DynoScan3D/DynoScan3D/Arduino Script/README.md

# Arduino-Controls

Arduino controls for turntable. Requires python script for serial communication.

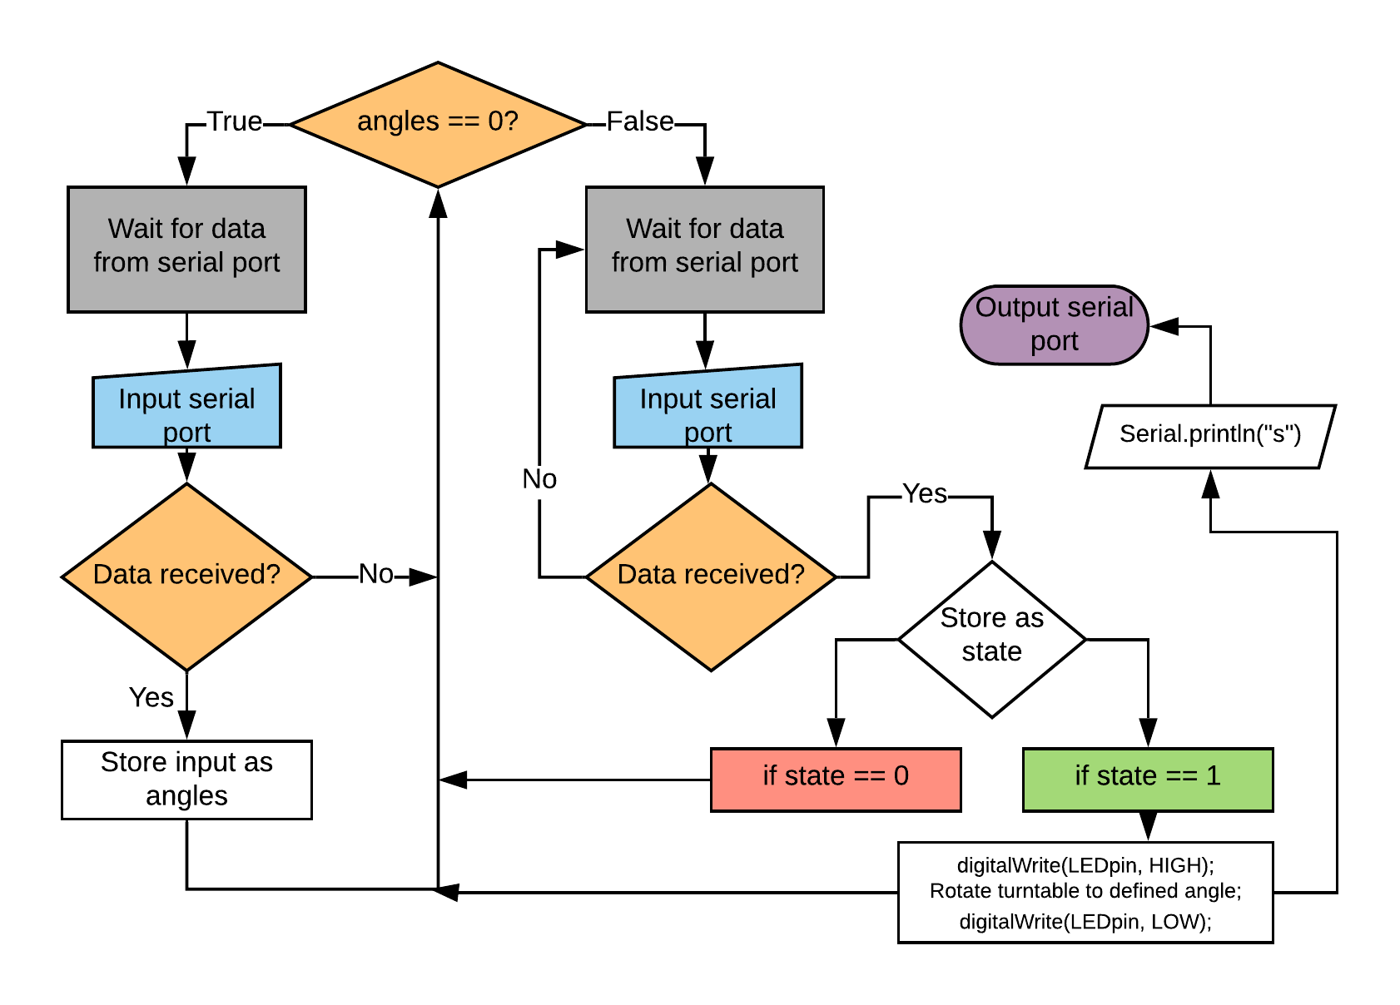
[picture p1: Arduino Script/ArduinoControlsChart.png]
ArduinoControlsChart
