DynoScan3D/DynoScan3D/AndroidImageCapture/ProjectAndCapturewithArduinoChart.png

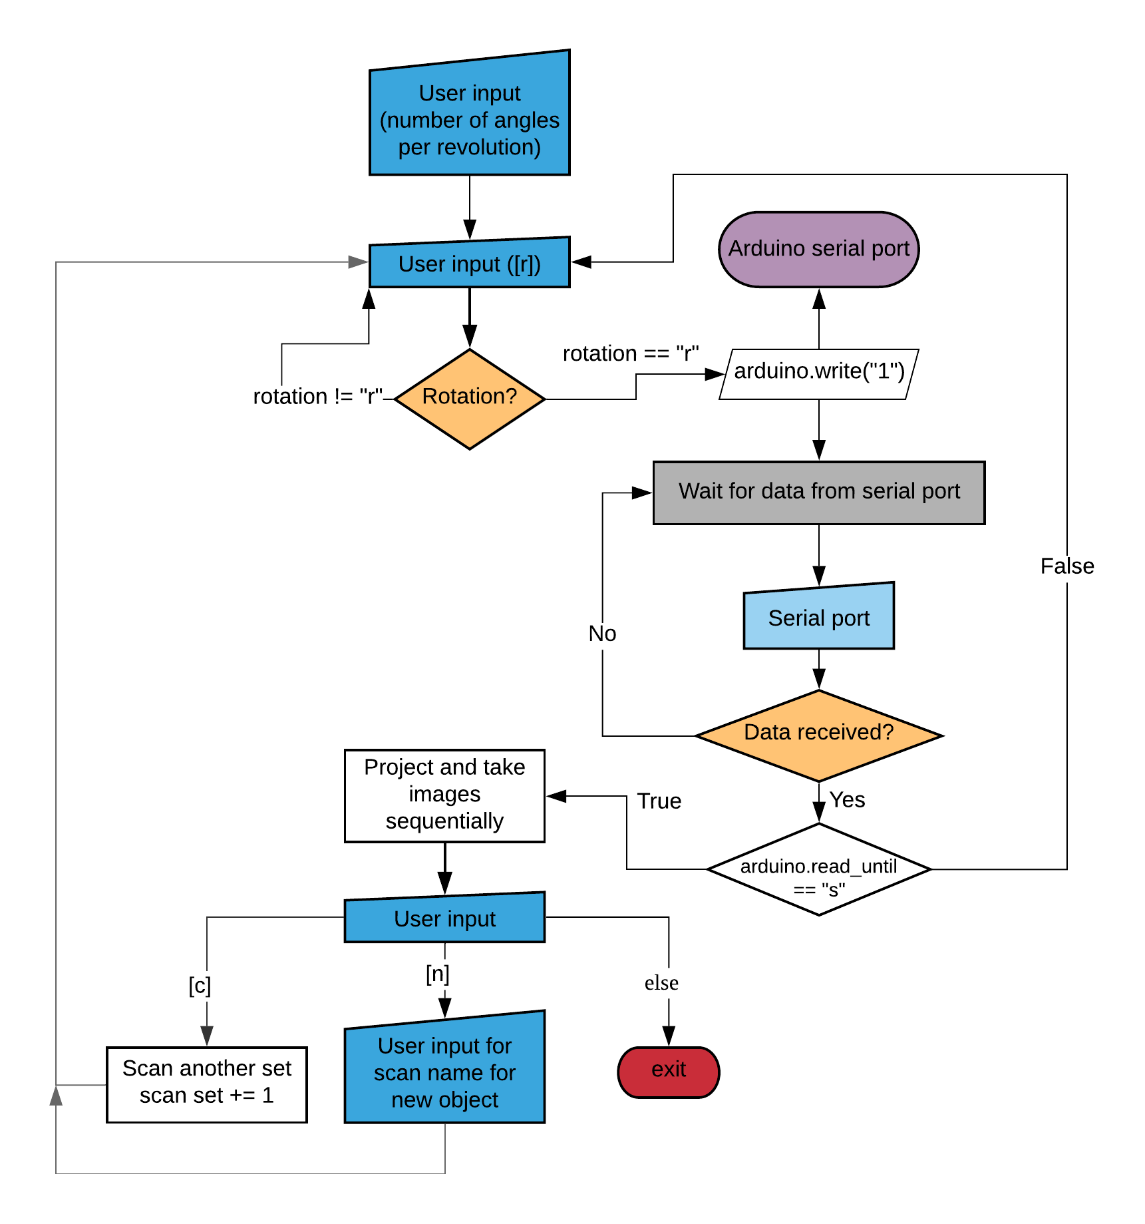
AndroidImageCapture/ProjectAndCapturewithArduinoChart.png
