DynoScan3D/DynoScan3D/DSLRImageCapture/GrayCodeImages/GrayCode3.jpg

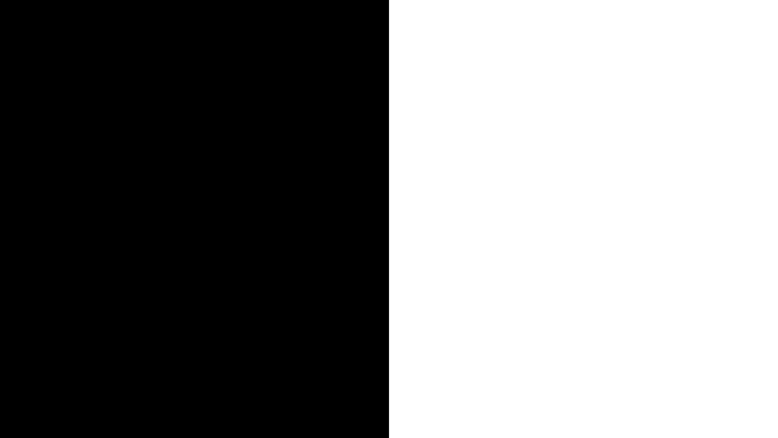
DSLRImageCapture/GrayCodeImages/GrayCode3.jpg
