DynoScan3D/DynoScan3D/DSLRImageCapture/GrayCodeImages/GrayCode4.jpg

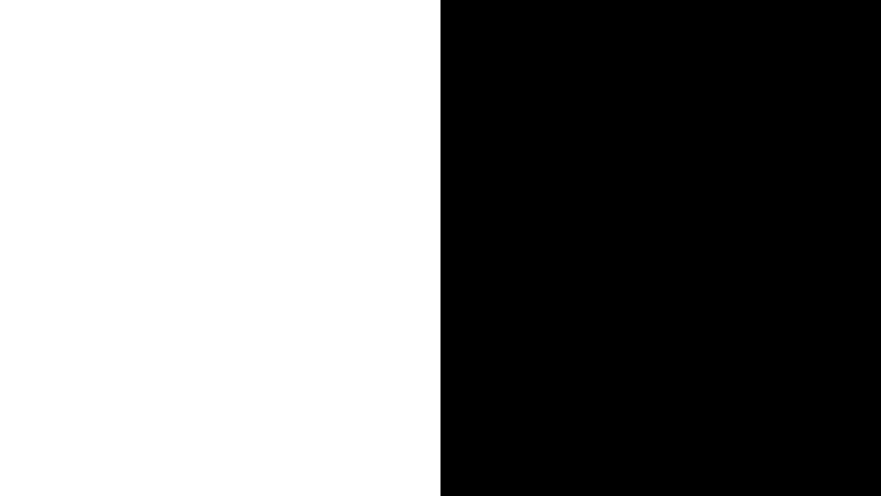
DSLRImageCapture/GrayCodeImages/GrayCode4.jpg
