DynoScan3D/DynoScan3D/DSLRImageCapture/GrayCodeImages/GrayCode5.jpg

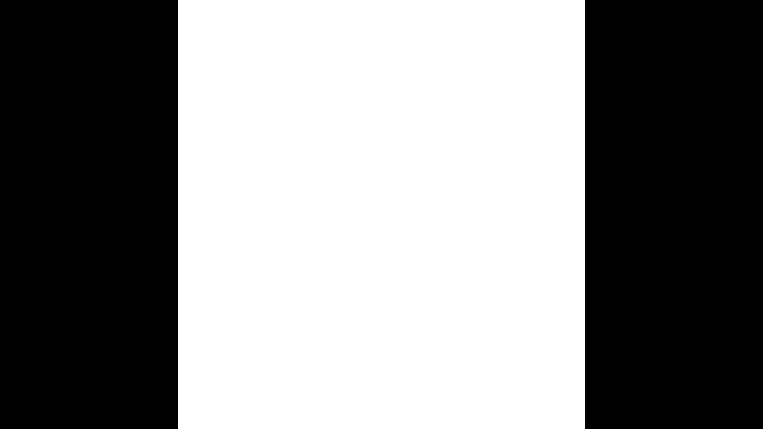
DSLRImageCapture/GrayCodeImages/GrayCode5.jpg
