DynoScan3D/DynoScan3D/DSLRImageCapture/GrayCodeImages/GrayCode6.jpg

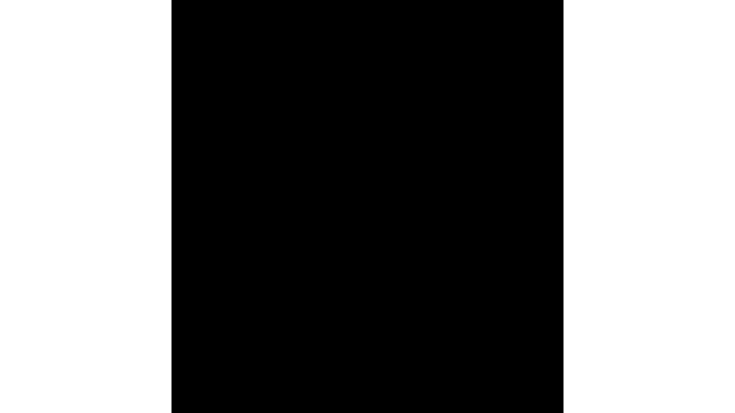
DSLRImageCapture/GrayCodeImages/GrayCode6.jpg
