DynoScan3D/DynoScan3D/DSLRImageCapture/GrayCodeImages/GrayCode7.jpg

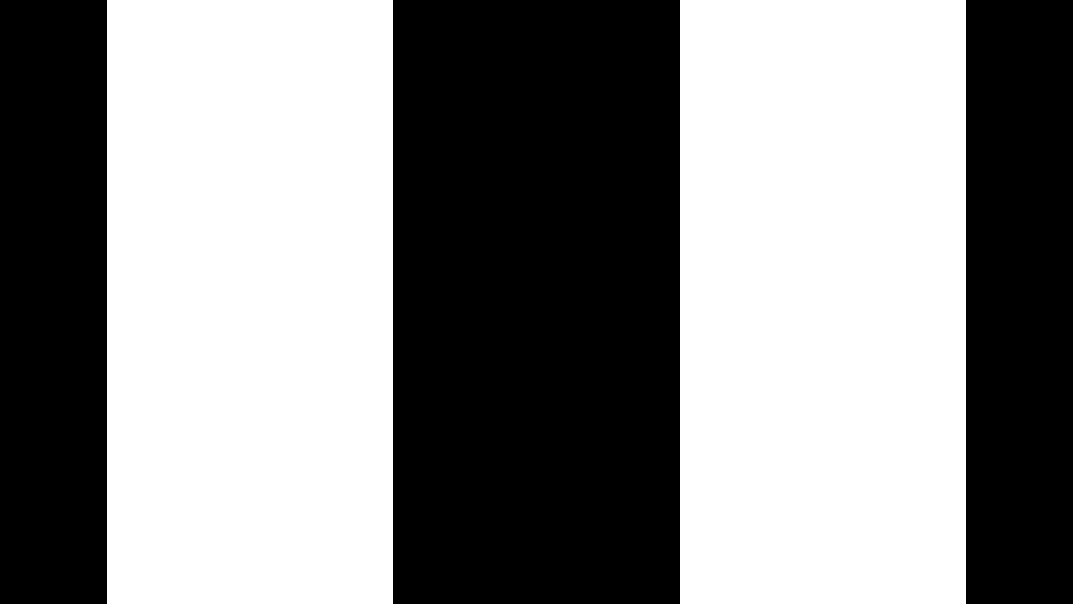
DSLRImageCapture/GrayCodeImages/GrayCode7.jpg
