DynoScan3D/DynoScan3D/DSLRImageCapture/GrayCodeImages/GrayCode8.jpg

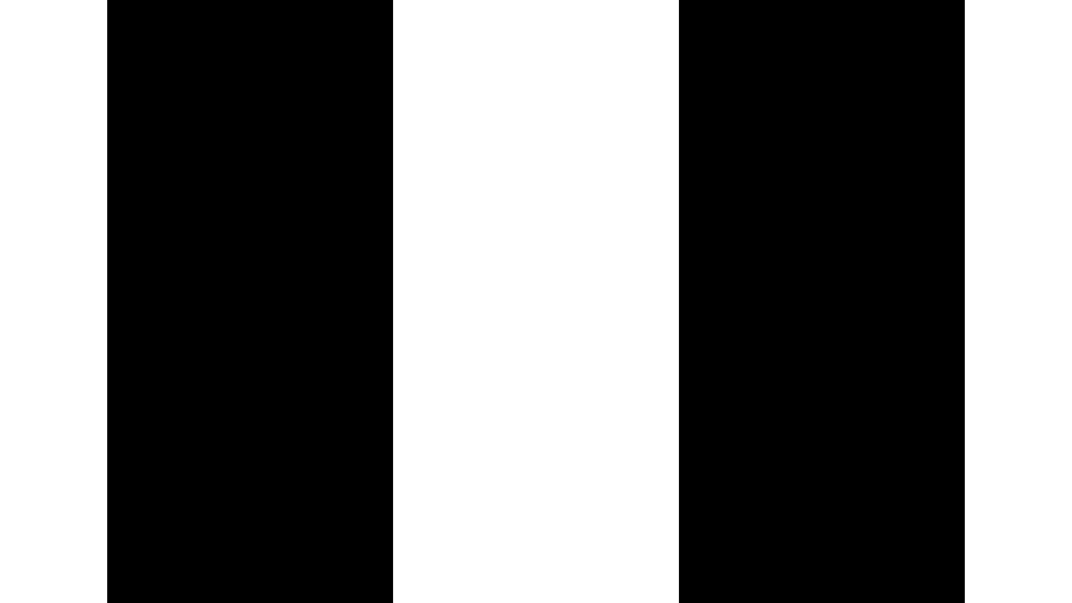
DSLRImageCapture/GrayCodeImages/GrayCode8.jpg
