DynoScan3D/DynoScan3D/DSLRImageCapture/GrayCodeImages/GrayCode9.jpg

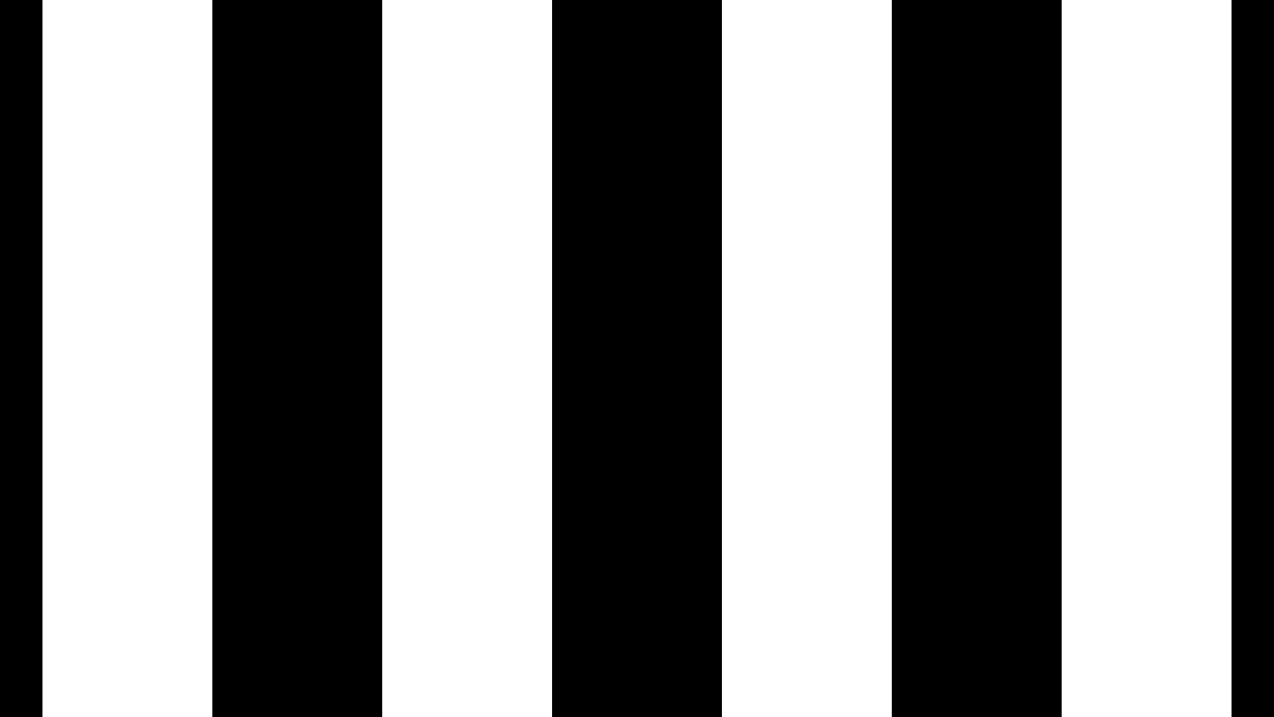
DSLRImageCapture/GrayCodeImages/GrayCode9.jpg
