DynoScan3D/DynoScan3D/DSLRImageCapture/GrayCodeImages/GrayCode10.jpg

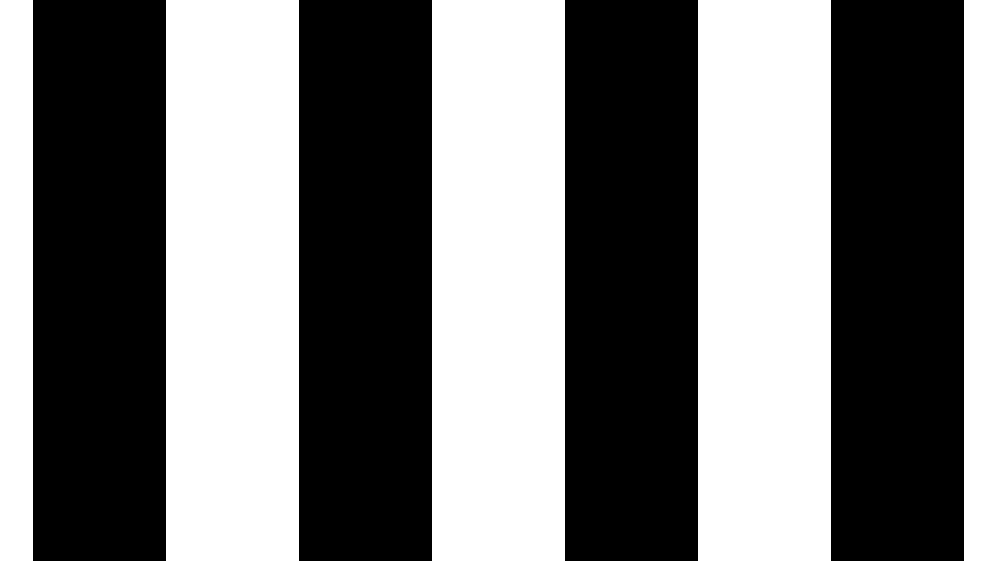
DSLRImageCapture/GrayCodeImages/GrayCode10.jpg
