DynoScan3D/DynoScan3D/DSLRImageCapture/GrayCodeImages/GrayCode13.jpg

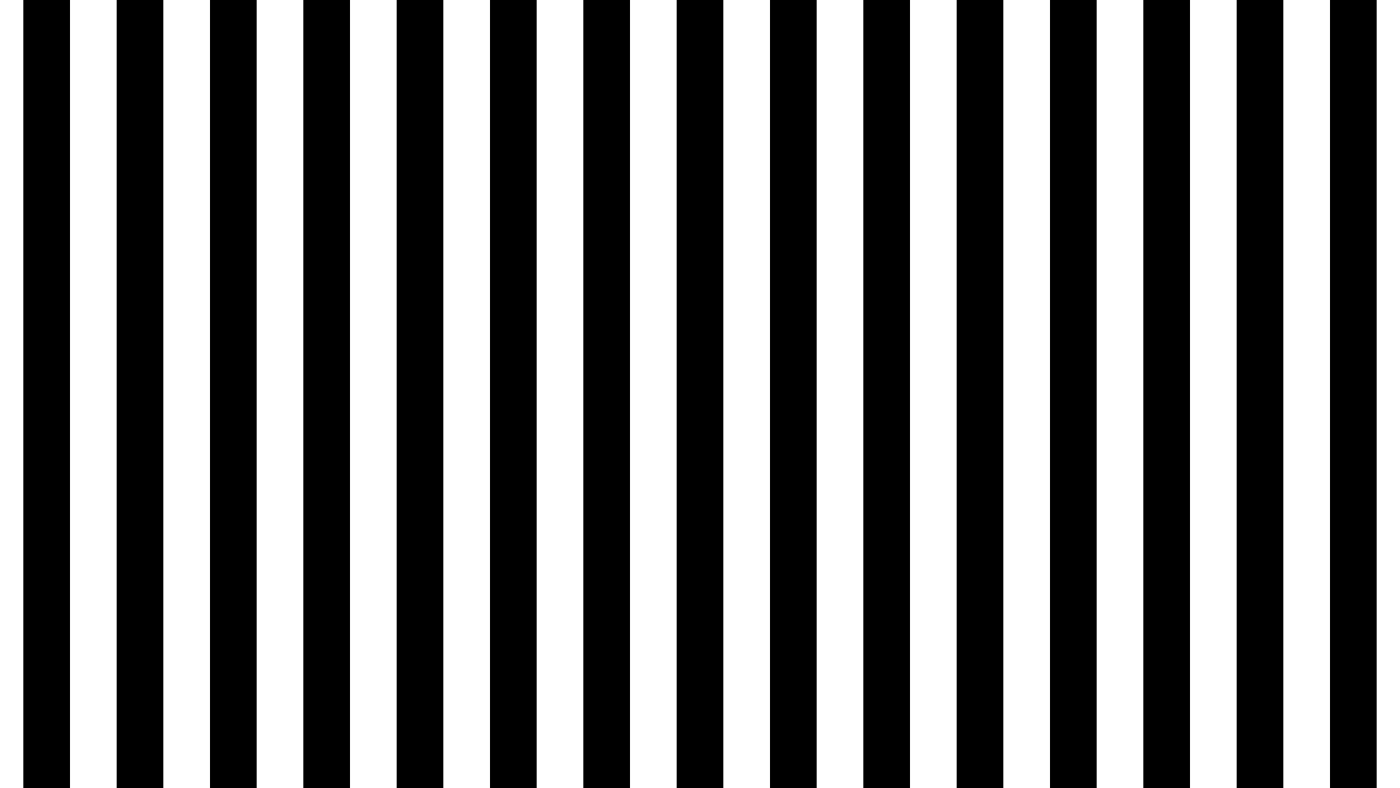
DSLRImageCapture/GrayCodeImages/GrayCode13.jpg
