DynoScan3D/DynoScan3D/DSLRImageCapture/GrayCodeImages/GrayCode14.jpg

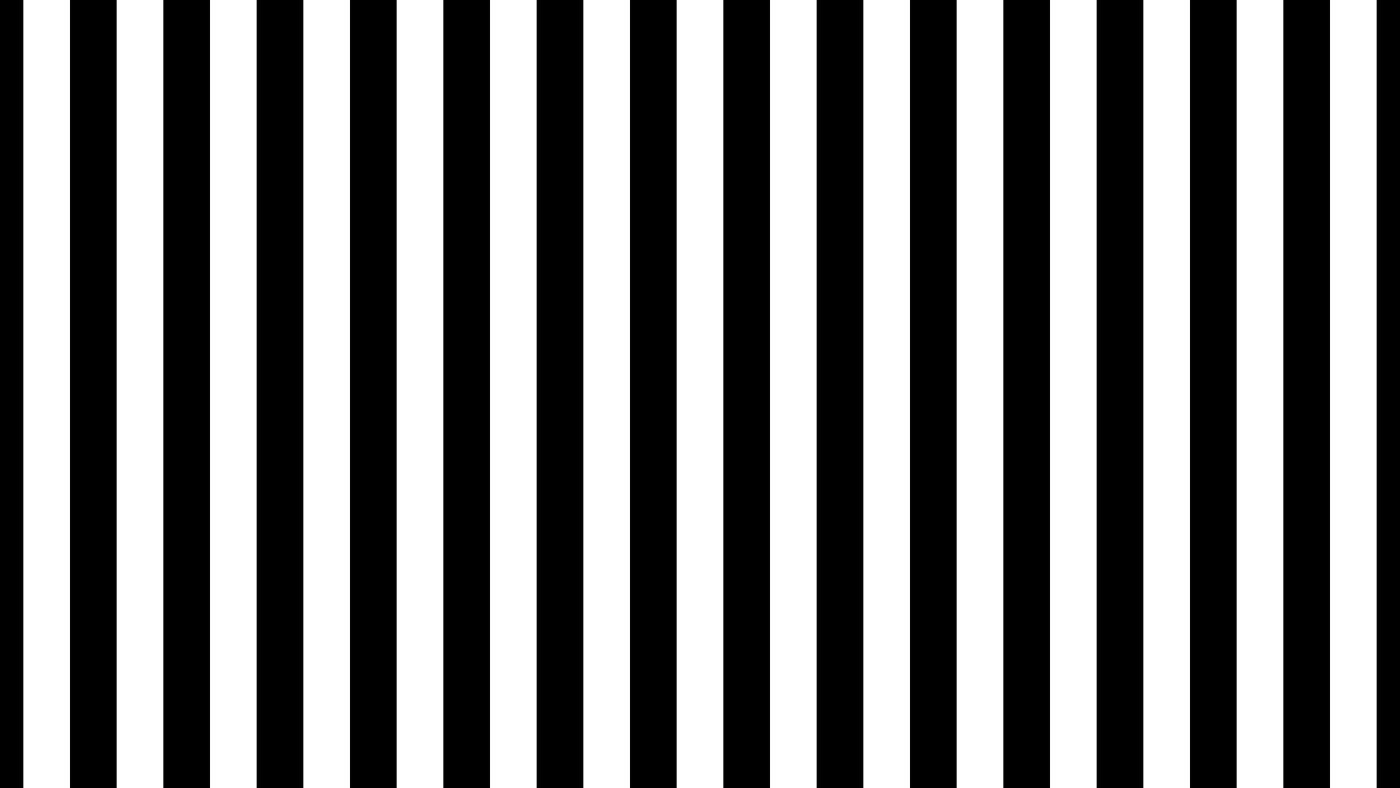
DSLRImageCapture/GrayCodeImages/GrayCode14.jpg
