DynoScan3D/DynoScan3D/DSLRImageCapture/GrayCodeImages/GrayCode18.jpg

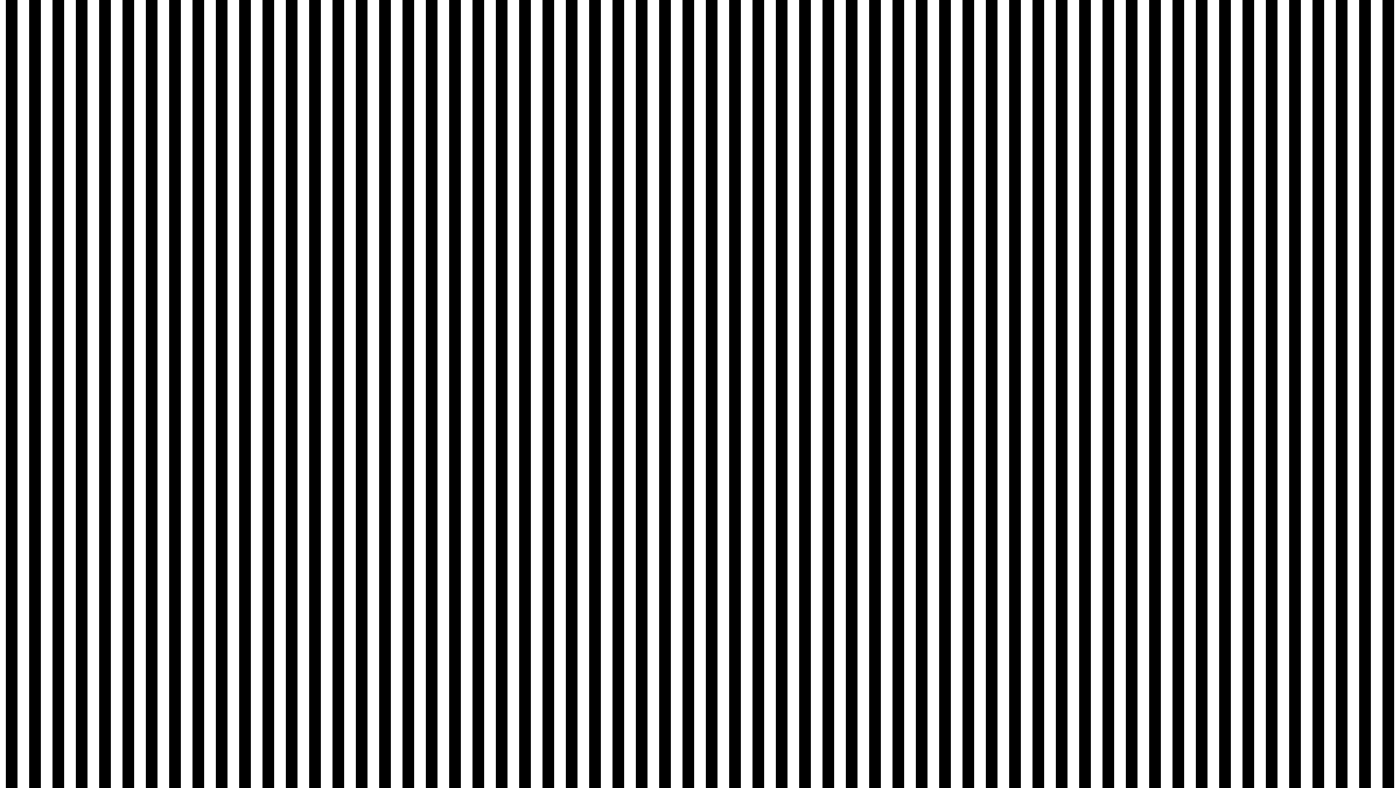
DSLRImageCapture/GrayCodeImages/GrayCode18.jpg
