DynoScan3D/DynoScan3D/DSLRImageCapture/GrayCodeImages/GrayCode20.jpg

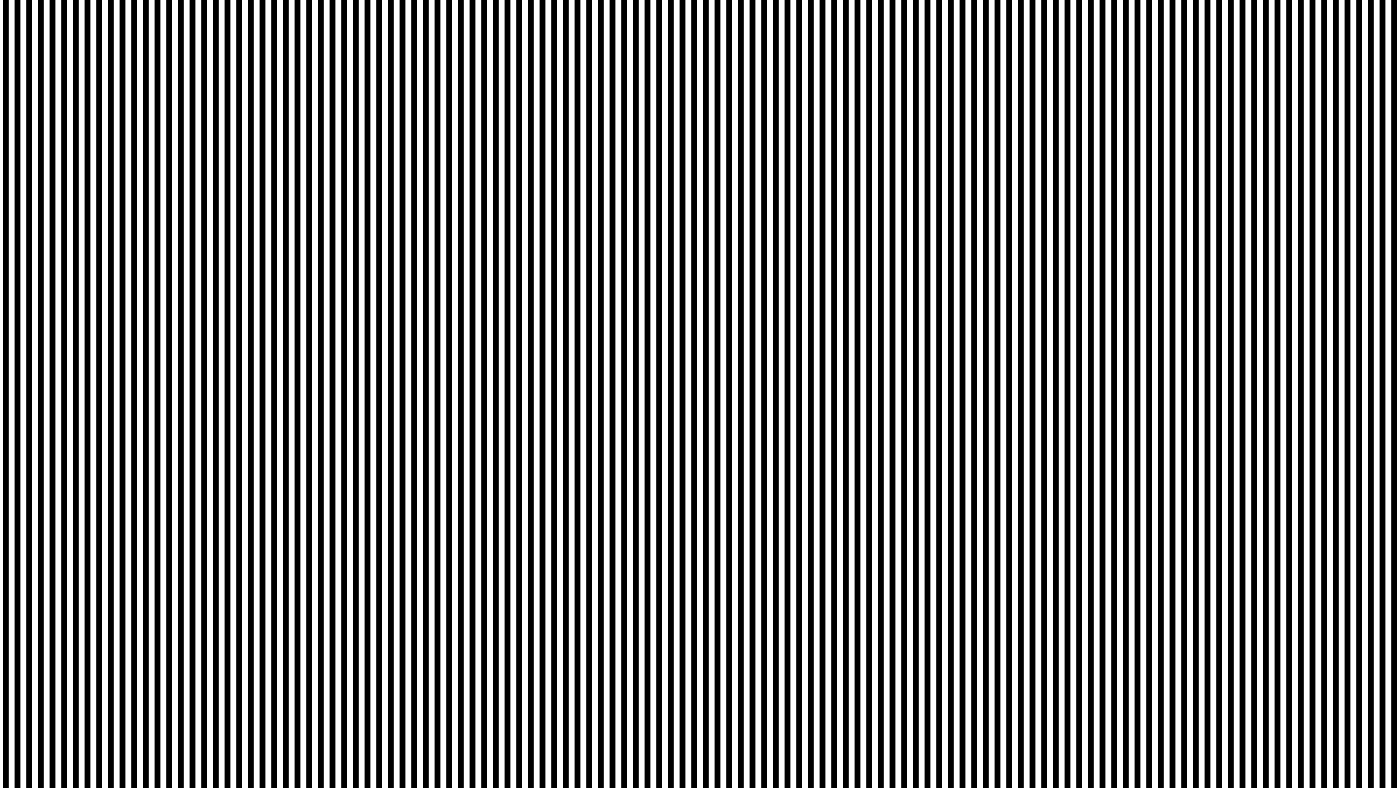
DSLRImageCapture/GrayCodeImages/GrayCode20.jpg
