DynoScan3D/DynoScan3D/GrayCode/Image/GrayCode023.jpg

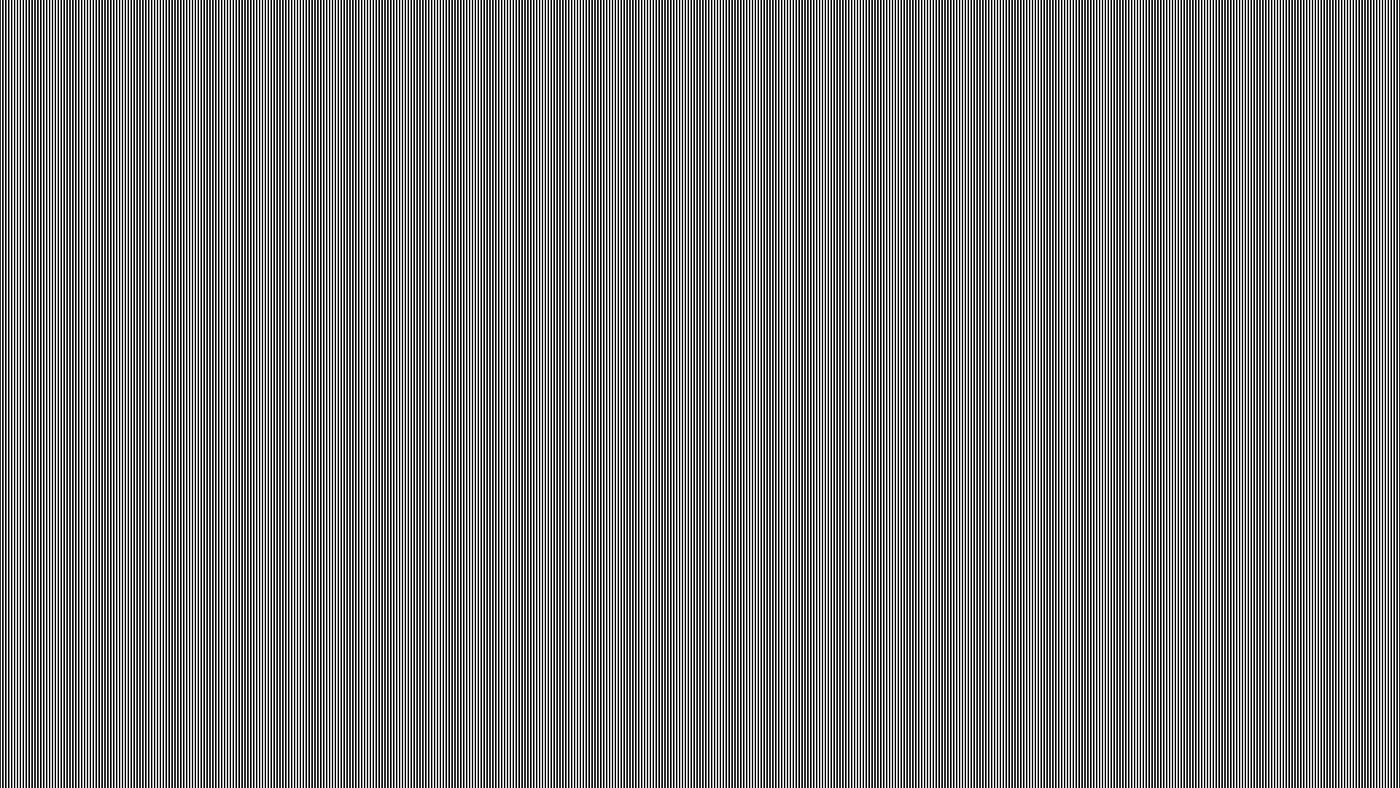
GrayCode/Image/GrayCode023.jpg
