DynoScan3D/DynoScan3D/PointCloudDistances/PhoneCar.png

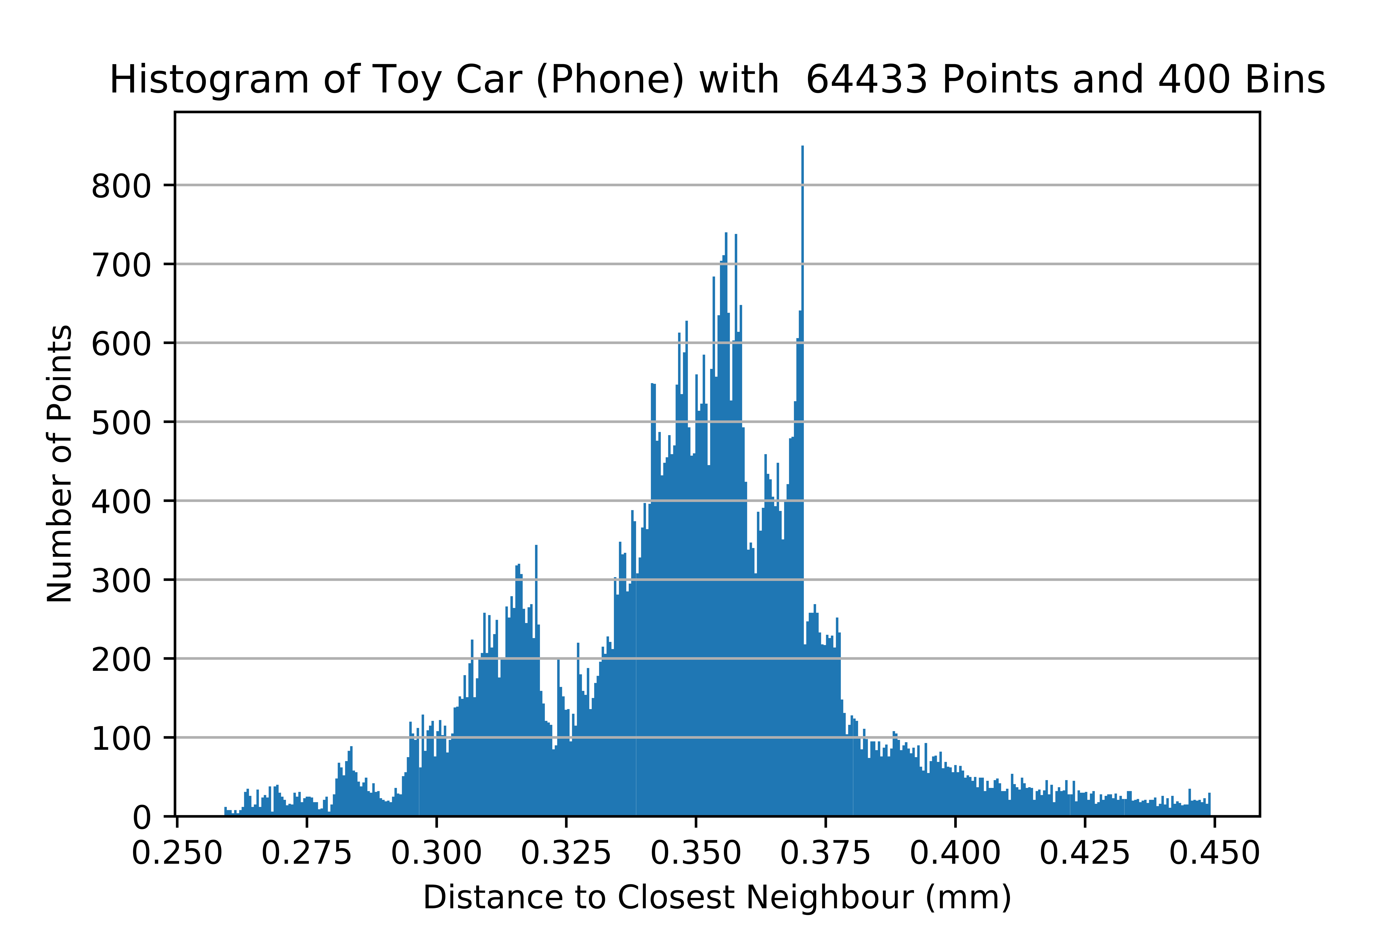
PointCloudDistances/PhoneCar.png
