DynoScan3D/DynoScan3D/PointCloudDistances/ShinyBlade5.png

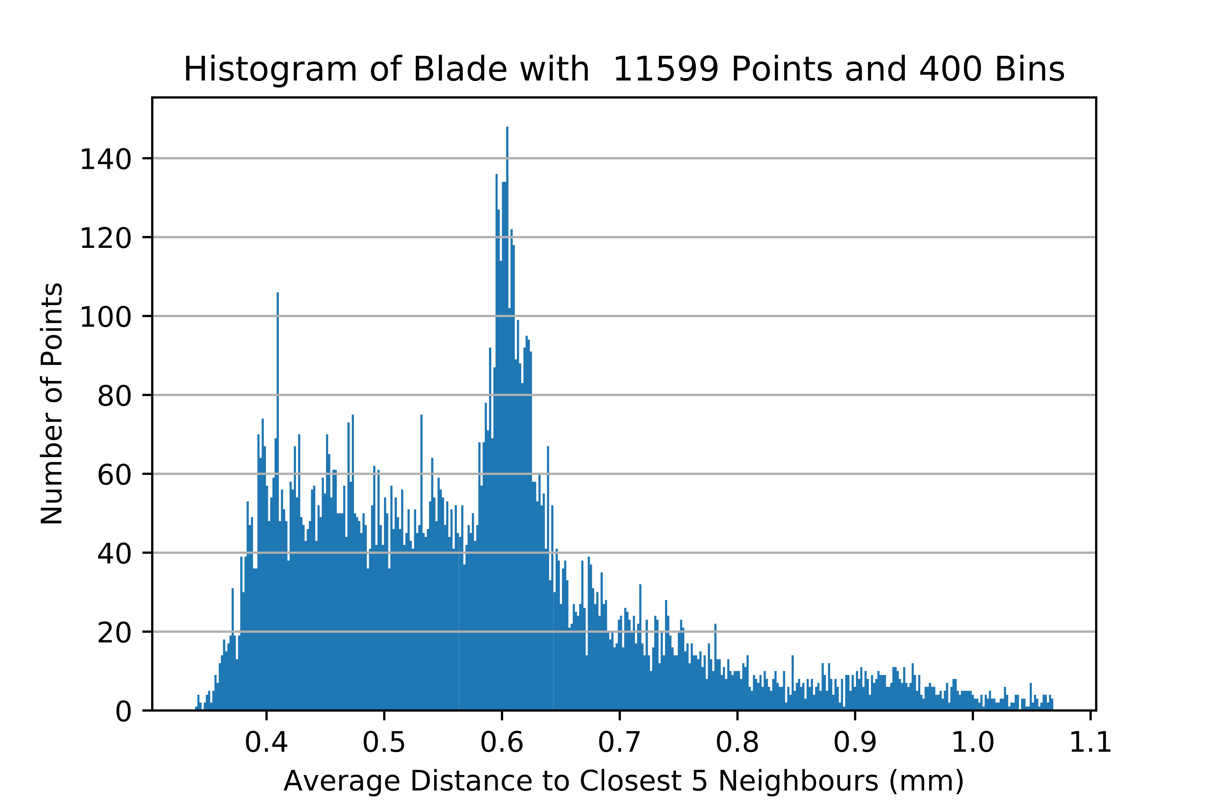
PointCloudDistances/ShinyBlade5.png
