DynoScan3D/DynoScan3D/PointCloudDistances/ShinyBlade.png

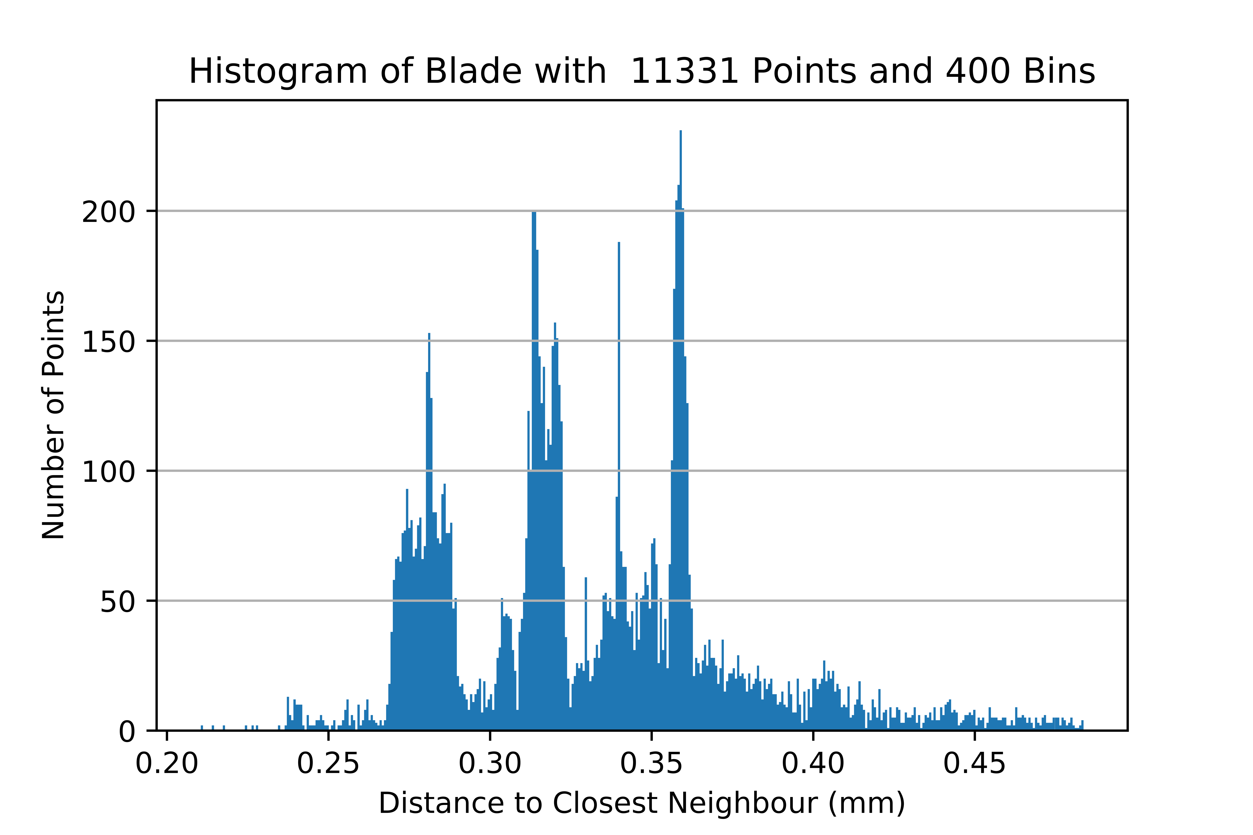
PointCloudDistances/ShinyBlade.png
