DynoScan3D/DynoScan3D/PointCloudDistances/SprayedBlade5.png

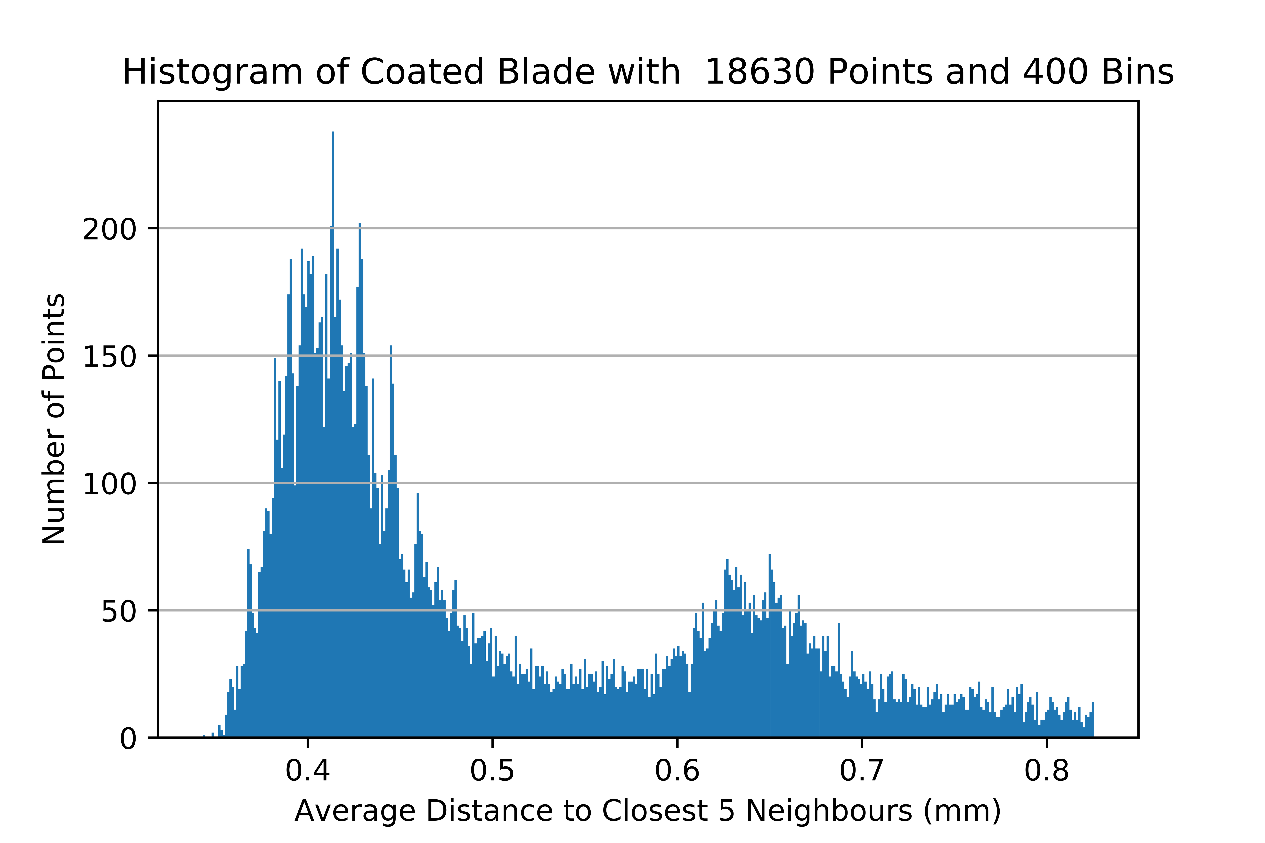
PointCloudDistances/SprayedBlade5.png
