DynoScan3D/DynoScan3D/PointCloudDistances/SprayedBlade.png

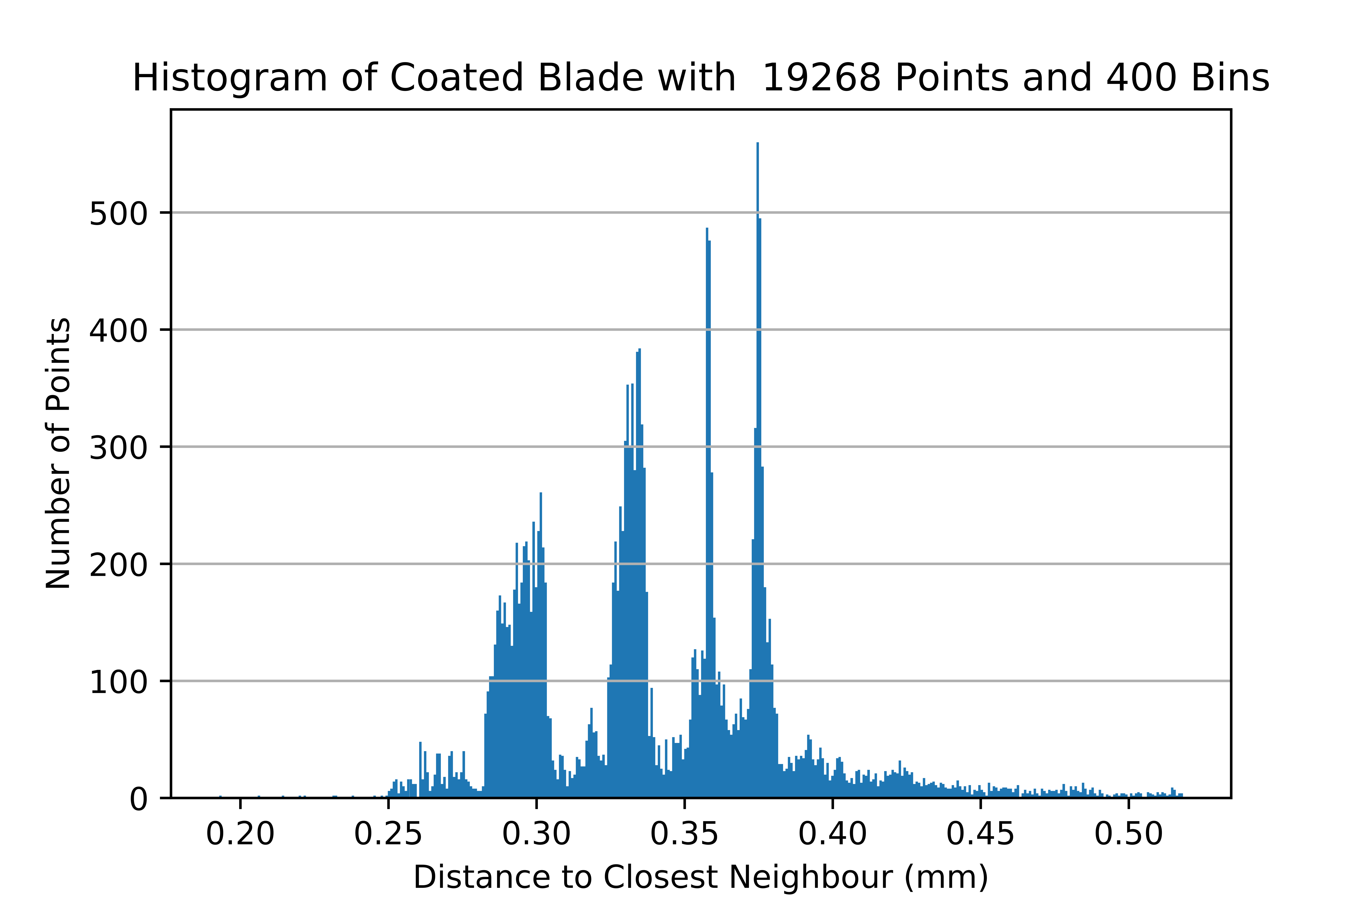
PointCloudDistances/SprayedBlade.png
