DynoScan3D/DynoScan3D/PointCloudDistances/WebcamCar.png

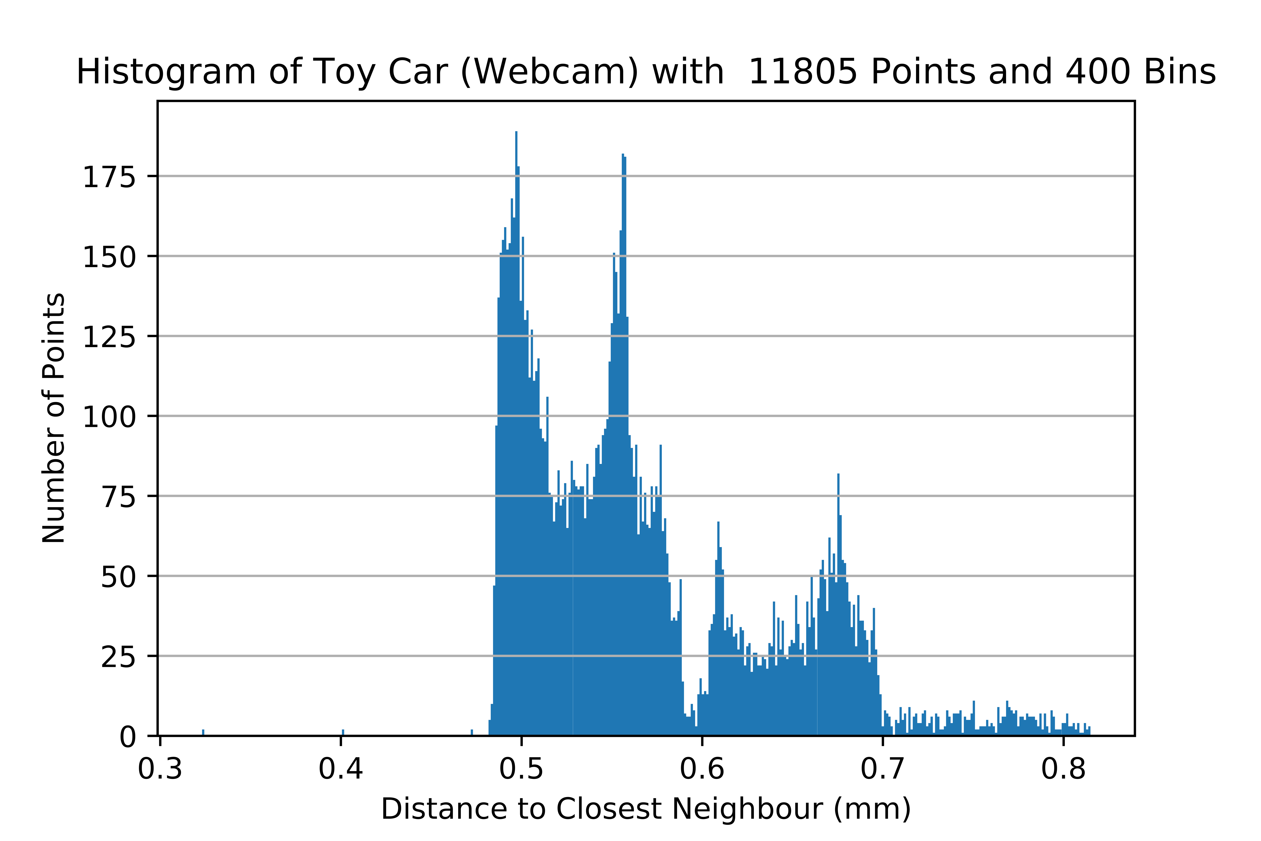
PointCloudDistances/WebcamCar.png
