DynoScan3D/DynoScan3D/Documents/Cost Sheet.pdf

Section | Vendor Name | Period | Item Description | Price (£) | Qty | Cost (£)
Scanning System | BT Business Direct Ltd | Jan-20 HD Pro Webcam C920 USB | 85.94 | 1 | 85.94
Royal Bank of Scotland plc | Jan-20 Battery powered projector & Tripod | 298.98 | 1 | 298.98
Transmission | RS Components Ltd | Dec-19 1 row radial ball bearing,2RS1 5 | 7.70 | 1 | 7.70
HPC Gears Ltd | Dec-19 1 row radial ball bearing,2RS1 1 | 20.06 | 1 | 20.06
HPC Gears Ltd | Mar-20 Reduced Backlash Timing Belt | 35.16 | 1 | 35.16
HPC Gears Ltd | Mar-20 Reduced Backlash Pulley | 81.88 | 1 | 81.88
HPC Gears Ltd | Mar-20 Reduced Backlash Pulley | 19.61 | 1 | 19.61
HPC Gears Ltd | Mar-20 Delivery | 22.74 | 1 | 22.74
Raw Materials | ME-Stores | Feb-20 Projector Slider | 1.45 | 1 | 1.45
ME-Stores | Feb-20 Frame | 13.70 | 1 | 13.70
ME-Stores | Feb-20 Projeector Plate | 1.66 | 1 | 1.66
ME-Stores | Feb-20 Camera Plate | 1.23 | 1 | 1.23
ME-Stores | Feb-20 Base Plate | 35.56 | 1 | 35.56
ME-Stores | Feb-20 Intermediate Plate | 2.99 | 1 | 2.99
ME-Stores | Feb-20 Motor Plate | 1.71 | 1 | 1.71
ME-Stores | Feb-20 Alu Sq Bar (Tripod) | 1.00 | 1 | 1.00
ME-Stores | Feb-20 Socket Countersunk Headscrew M3 | 0.29 | 3 | 0.87
ME-Stores | Feb-20 Hex Nut M3 | 0.03 | 5 | 0.15
ME-Stores | Feb-20 Plain Washer M3 | 0.02 | 20 | 0.40
ME-Stores | Feb-20 Socket Countersunk Headscrew M5 | 0.15 | 23 | 3.45
ME-Stores | Feb-20 Plain Washer M5 | 0.02 | 4 | 0.08
ME-Stores | Feb-20 Hex Nut M5 | 0.03 | 9 | 0.27
ME-Stores | Feb-20 Socket head Capscrew M3 | 0.10 | 2 | 0.20
ME-Stores | Feb-20 Socket Countersunk Headscrew M3 | 0.16 | 2 | 0.32
ME-Stores | Feb-20 Hex Screw M5 | 0.06 | 14 | 0.84
ME-Stores | Feb-20 Socket head Capscrew M5 | 0.08 | 4 | 0.32
ME-Stores | Feb-20 Pin | 0.30 | 3 | 0.90
ME-Stores | Feb-20 Washer ISO M6 | 0.03 | 1 | 0.03
ME-Stores | Feb-20 Hex Nut M8 | 0.03 | 2 | 0.06
ME-Stores | Feb-20 Socket Head Cap Screw | 0.18 | 2 | 0.36
ME-Stores | Feb-20 Washer ISO M8 | 0.03 | 2 | 0.06
RS Components Ltd | Feb-20 Hinge | 2.15 | 6 | 12.91
RS Components Ltd | Feb-20 Handle | 3.47 | 2 | 6.93
RS Components Ltd | Feb-20 GB VAT | 3.97 | 1 | 3.97
ME-Stores | Mar-20 Additional Fasteners (estimate) | 5.00 | 1 | 5.00
Amazon | Apr-20 Rubber Stopper | 4.34 | 1 | 4.34
Amazon | Apr-20 Frame Cloth | 12.99 | 1 | 12.99
Control | RS Components Ltd | Dec-19 57mm stepper motor,189Ncm 1.8deg | 80.17 | 1 | 80.17
RS Components Ltd | Dec-19 ARDUINO UNO SMD REV3,A000073 | 18.76 | 1 | 18.76
Hobbytronics | Feb-20 Stepper Motor Driver | 4.74 | 1 | 4.74
RS Components Ltd | Feb-20 Female Connector Housing | 1.67 Pack | 1.67
RS Components Ltd | Feb-20 Female Crimp Terminal | 2.45 Pack | 2.45
RS Components Ltd | Feb-20 4 Way PCB Header x5 | 1.67 Pack | 1.67
RS Components Ltd | Feb-20 AC/DC Convertor | 19.12 | 1 | 19.12
RS Components Ltd | Feb-20 Switch | 4.19 Pack | 4.19
RS Components Ltd | Feb-20 Ardunio Proto Shield | 8.92 | 1 | 8.92
RS Components Ltd | Feb-20 GB VAT | 7.60 | 1 | 7.60
RS Components Ltd | Mar-20 Keyboard Switch (Safety Switch) | 1.86 Pack | 1.86
RS Components Ltd | Mar-20 LED Light | 2.52 Pack | 2.52
Prototype | ME-Stores | Nov-19 Aluminium round bar | 0.15 | 1 | 0.15
ME-Stores | Nov-19 Aluminium round bar | 1.00 | 1 | 1.00
ME-Stores | Nov-19 Mild Steel round bar | 1.00 | 1 | 1.00
ME-Stores | Nov-19 Aluminium sheet | 1.40 | 1 | 1.40
ME-Stores | Nov-19 Aluminium sheet | 1.00 | 1 | 1.00
ME-Stores | Nov-19 Aluminium sheet | 7.50 | 1 | 7.50
ME-Stores | Nov-19 Aluminium round bar | 1.00 | 1 | 1.00
ME-Stores | Nov-19 Aluminium square bar | 1.96 | 1 | 1.96
ME-Stores | Nov-19 Aluminium sheet | 28.27 | 1 | 28.27
ME-Stores | Nov-19 Machine Screw - Countersink | 0.04 | 15 | 0.60
ME-Stores | Nov-19 Nuts - Steel | 0.03 | 4 | 0.12
ME-Stores | Nov-19 Socket Cap Head Screw | 0.10 | 1 | 0.10
ME-Stores | Nov-19 Washers - Steel | 0.02 | 12 | 0.24
ME-Stores | Nov-19 Dowel Pin | 0.30 | 3 | 0.90
ME-Stores | Nov-19 Dowel Pin | 0.30 | 1 | 0.30
ME-Stores | Nov-19 Hex Head Bolts | 0.05 | 8 | 0.40
ME-Stores | Dec-19 24ABT 5-15 Timing Pulleys | 35.80 | 1 | 35.80
ME-Stores | Dec-19 Delivery | 9.40 | 1 | 9.40
ME-Stores | Dec-19 AT5/720 Timing Belt | 25.42 | 1 | 25.42
ME-Stores | Dec-19 GB VAT - GB VAT | 14.12 | 1 | 14.12
ME-Stores | Jan-20 Prototyping (3 Metal Plates) | 22.90 | 1 | 22.90
| | | | | Grand Total | 993.07
