DynoScan3D/DynoScan3D/(list of files, cad)

Other CAD files:
PointCloudDistances/BladeSpray.ply
PointCloudDistances/BladeShiny.ply
PointCloudDistances/PhoneCar.ply
PointCloudDistances/WebcamCar.ply
PointCloudDistances/OldScannerCar.ply
