DynoScan3D/DynoScan3D/Drawings/Turntable Sub-assembly.PDF

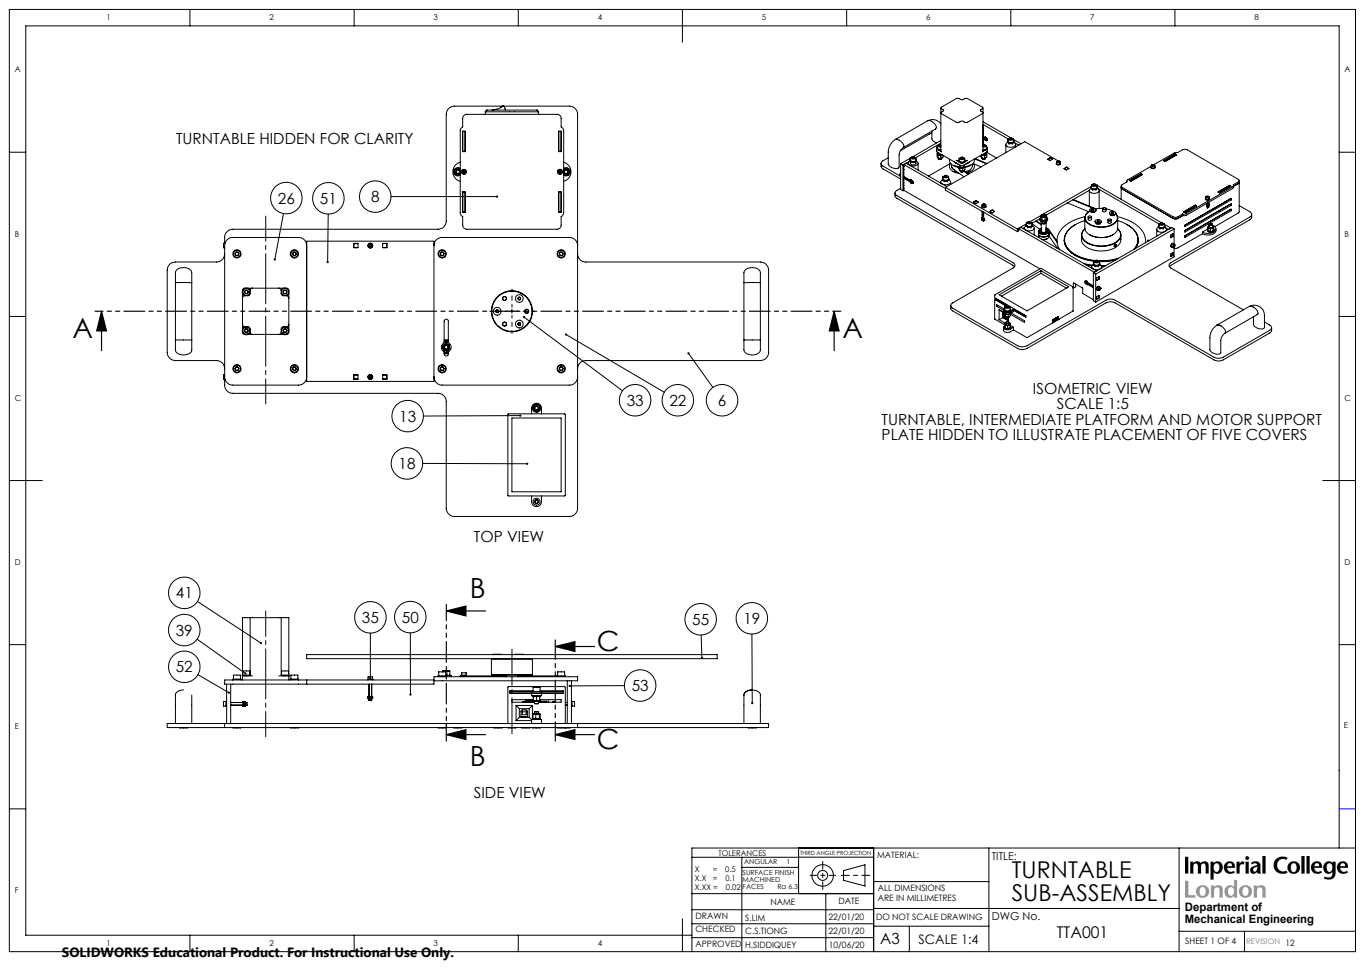
[picture p86: page 1]
TOP VIEW; SIDE VIEW; ISOMETRIC VIEW SCALE 1:5; SURFACE FINISH; FACES; ANGULAR 1; DWG No.; A3 SCALE 1:4; SHEET 1 OF 4; REVISION 12; Department of Mechanical Engineering

TURNTABLE HIDDEN FOR CLARITY

TURNTABLE, INTERMEDIATE PLATFORM AND MOTOR SUPPORT
PLATE HIDDEN TO ILLUSTRATE PLACEMENT OF FIVE COVERS

THIRD ANGLE PROJECTION

ALL DIMENSIONS
ARE IN MILLIMETRES
DO NOT SCALE DRAWING

SOLIDWORKS Educational Product. For Instructional Use Only.

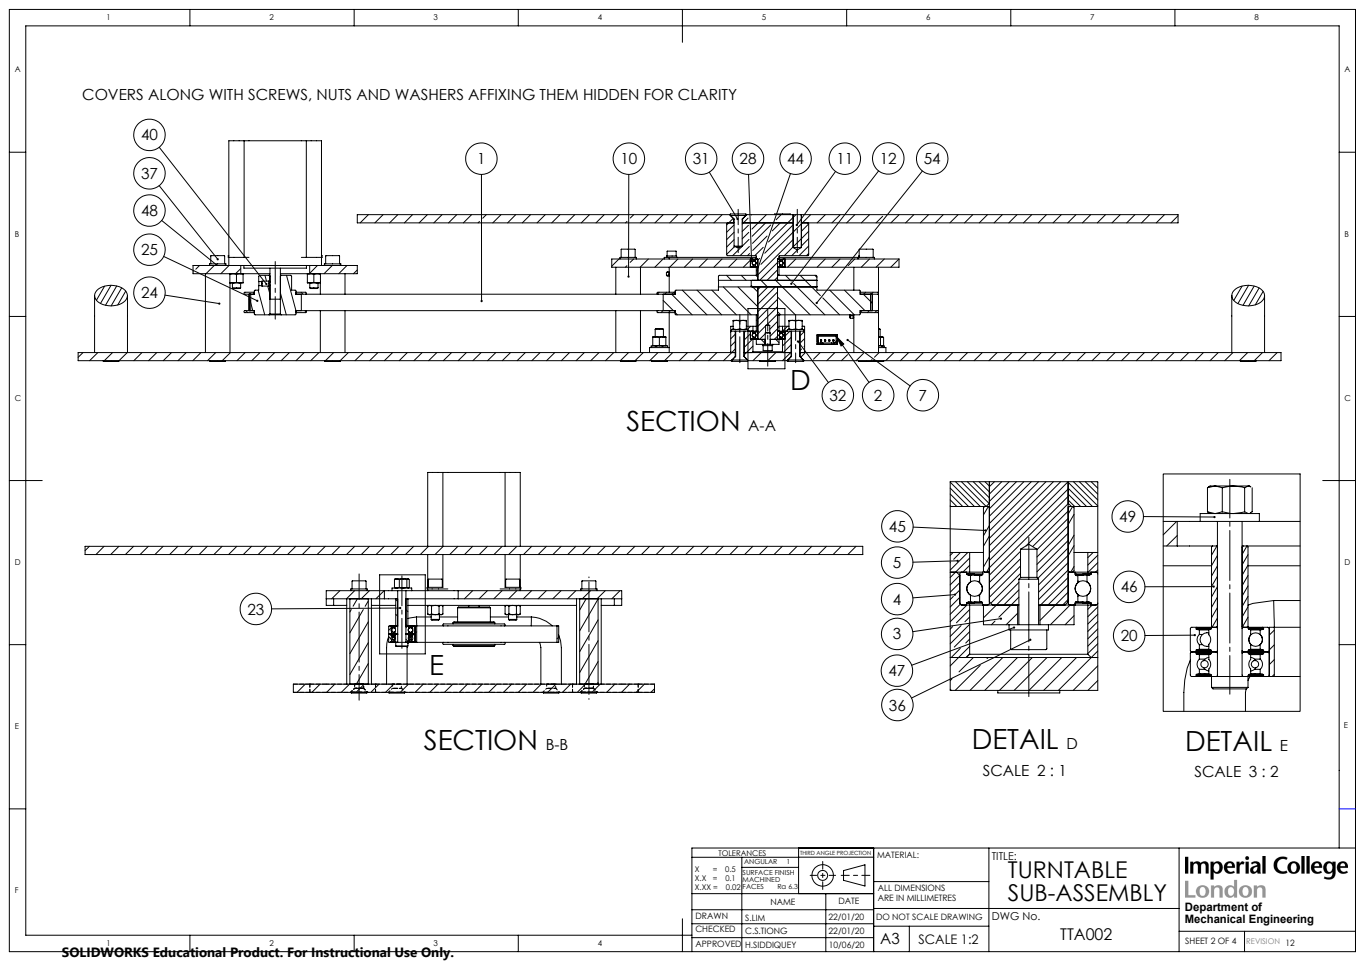
[picture p87: page 2]
SECTION A-A; SECTION B-B; DETAIL E; SCALE 3 : 2; DETAIL D; SCALE 2 : 1; SURFACE FINISH; ANGULAR 1; A3 SCALE 1:2; SHEET 2 OF 4

COVERS ALONG WITH SCREWS, NUTS AND WASHERS AFFIXING THEM HIDDEN FOR CLARITY

THIRD ANGLE PROJECTION

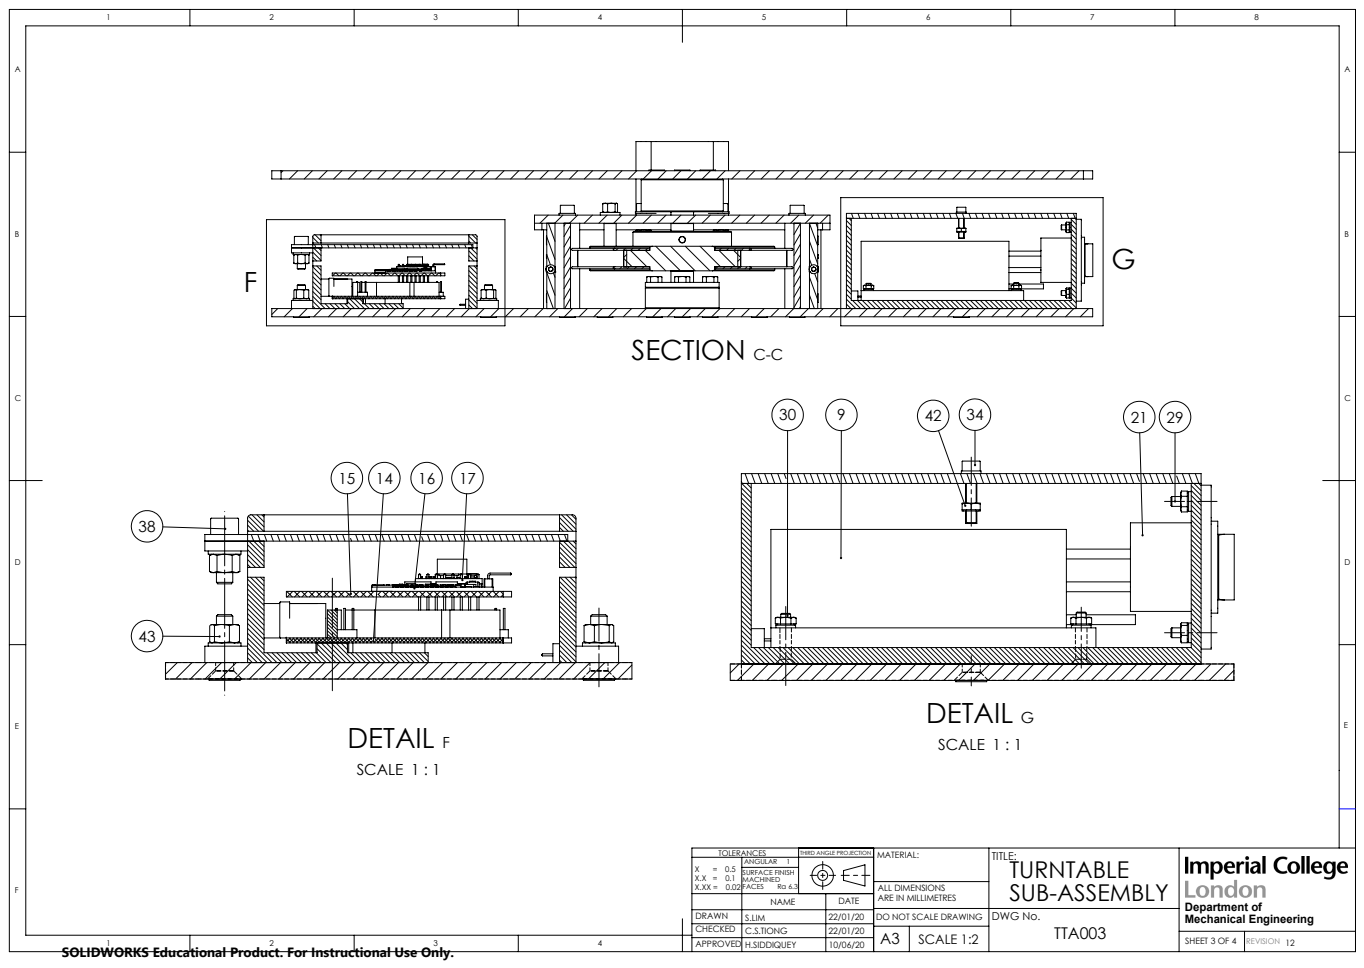
[picture p88: page 3]
SECTION C-C; DETAIL F; SCALE 1 : 1; DETAIL G; SURFACE FINISH; ANGULAR 1; A3 SCALE 1:2; SHEET 3 OF 4

THIRD ANGLE PROJECTION

THIRD ANGLE PROJECTION

ITEM NO. | PART NUMBER | DESCRIPTION | QTY. | ITEM NO. | PART NUMBER | DESCRIPTION | QTY.
1 | AT5/860 | TIMING BELT | 1 | 31 | SCHS5x20 | SOCKET COUNTERSUNK HEAD SCREW - M5x20 (164119/10SCs) | 19
2 | B4B001 | B4B-XH-A | 4
3 | BC001 | BEARING CAP | 1
4 | BH001 | BEARING HOUSING - BOTTOM | 1
5 | BH002 | BEARING HOUSING - LID | 1
6 | BP001 | BASE PLATE | 1
7 | CB001 | CONVERTER BOX | 1 | 35 | SHCS3x25 | SOCKET HEAD CAP SCREW - M3x25 (164119/10SC) | 6
8 | CB002 | CONVERTER BOX COVER | 1
9 | CON001 | AC-DC CONVERTER - RS 644-7067 | 1
10 | CP001 | CENTRE PILLAR | 4
11 | DP3x20 | DOWEL PIN - M3x20 (164119/10PiDm) | 3
12 | DP4x40 | DOWEL PIN - M4x40 | 1
| | | | 39 | SHCS5x20 | SOCKET HEAD CAP SCREW - M5x20 (164119/10SC) | 4
13 | EB001 | ELECTRONIC BOX | 1
14 | EB002 | ARDUINO UNO | 1
| | | | 40 | SHSS3x5 | SOCKET HEAD SET SCREW - M3x5 (164119/10SS) | 1
15 | EB003 | ARDUINO PROTO SHIELD R3 | 1
16 | EB004 | HC-05-01 | 1
| | | | 41 | SM001 | STEPPER MOTOR - RS 535-0445 | 1
17 | EB005 | ARDUINO DRIVER A4988 | 1
| | | | 42 | SN3 | STEEL NUT - M3 | 13
18 | EC001 | ELECTRONICS COVER | 1
| | | | 43 | SN5 | STEEL NUT - M5 | 14
19 | HDL001 | HANDLE - RS 456-551 | 2
| | | | 44 | SP001 | SPACER - MAIN SHAFT 5mm | 1
20 | IB001 | IDLER BEARING - 625-2RS1 | 2
| | | | 45 | SP002 | SPACER - MAIN SHAFT 10mm | 1
21 | IEC001 | IEC CONNECTOR - RS 867-7295 | 1 | 46 | SP003 | SPACER - IDLER | 1
22 | IP001 | INTERMEDIATE PLATFORM | 1 | 47 | SW3 | STEEL WASHER - M3 | 14
23 | IS001 | IDLER SHAFT | 1 | 48 | SW5 | STEEL WASHER - M5 | 21
24 | MP001 | MOTOR PILLAR | 4 | 49 | SW6 | STEEL WASHER - M6 | 1
25 | MP001 | MOTOR PULLEY - 20ABT 5-15 | 1 | 50 | TC001 | TRANSMISSION COVER - SIDE | 2
26 | MS001 | MOTOR SUPPORT PLATE | 1 | 51 | TC002 | TRANSMISSION COVER - TOP | 1
28 | SB001 | SHAFT BEARING - 61801-2RS1 | 2 | 52 | TC003 | TRANSMISSION COVER - MOTOR | 1
29 | SCHS3x12 | SOCKET COUNTERSUNK HEAD SCREW - M3x12 (164119/10SCs) | 2 | 53 | TC004 | TRANSMISSION COVER - PULLEY | 1
| | | | 54 | TP001 | TURNTABLE PULLEY - 80ABT 5-15 | 1
| | | | 55 | TT001 | TURNTABLE | 1
30 | SCHS3x8 | SOCKET COUNTERSUNK HEAD SCREW - M3x8
(164119/10SCs) | 3
32 | SCHS5x25 | SOCKET COUNTERSUNK HEAD SCREW - M5x25 (164119/10SCs) | 4
33 | SH001 | MAIN SHAFT | 1
34 | SHCS3x16 | SOCKET HEAD CAP SCREW - M3x16 (164119/10SC) | 2
36 | SHCS3x8 | SOCKET HEAD CAP SCREW - M3x8 (164119/10SC) | 1
37 | SHCS5x10 | SOCKET HEAD CAP SCREW - M5x10 (164119/10SC) | 8
38 | SHCS5x15 | SOCKET HEAD CAP SCREW - M5x15 (164119/10SC) | 1

D

E

C

B

C

D

B

SURFACE FINISH
MACHINED
ANGULAR 1 | TURNTABLE SUB-ASSEMBLY BOM
A3 | SHEET 4 OF 4

TITLE:
MATERIAL:
X = 0.5
X.X = 0.1

TOLERANCES

E
