DynoScan3D/DynoScan3D/Drawings/General Assembly.pdf

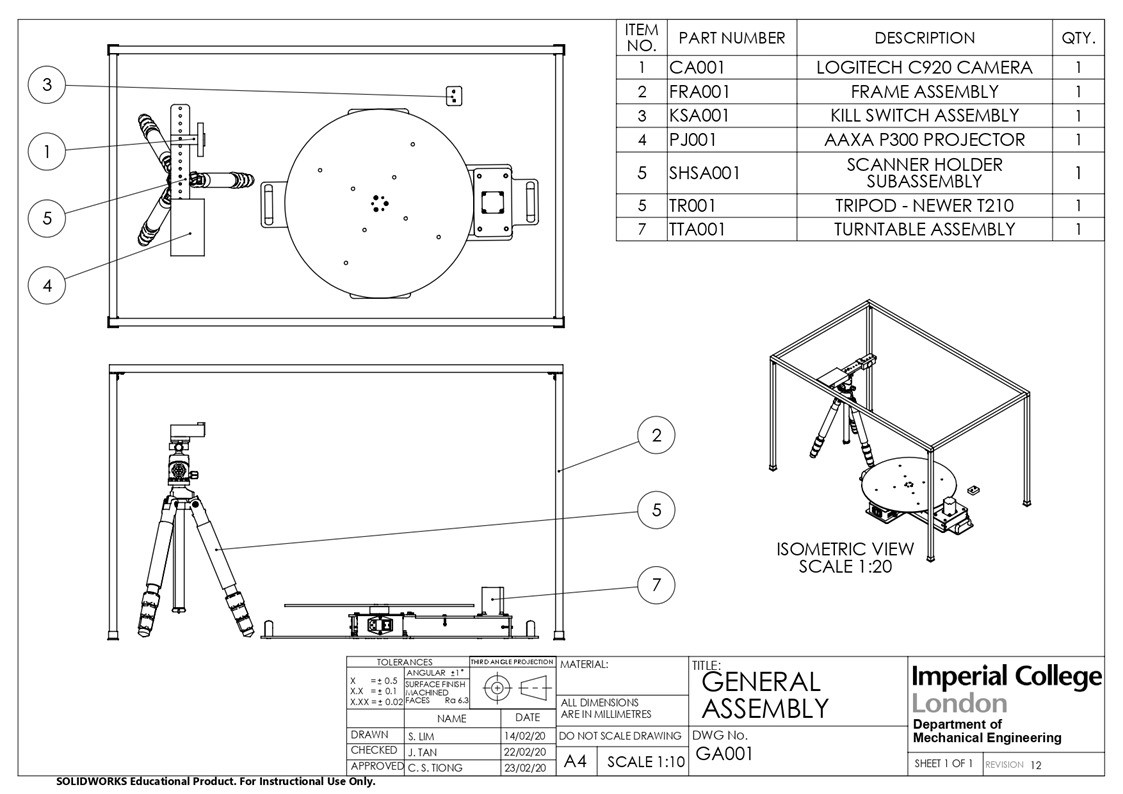
[picture p89: page 1]
