DynoScan3D/DynoScan3D/Drawings/Electronic Box.PDF

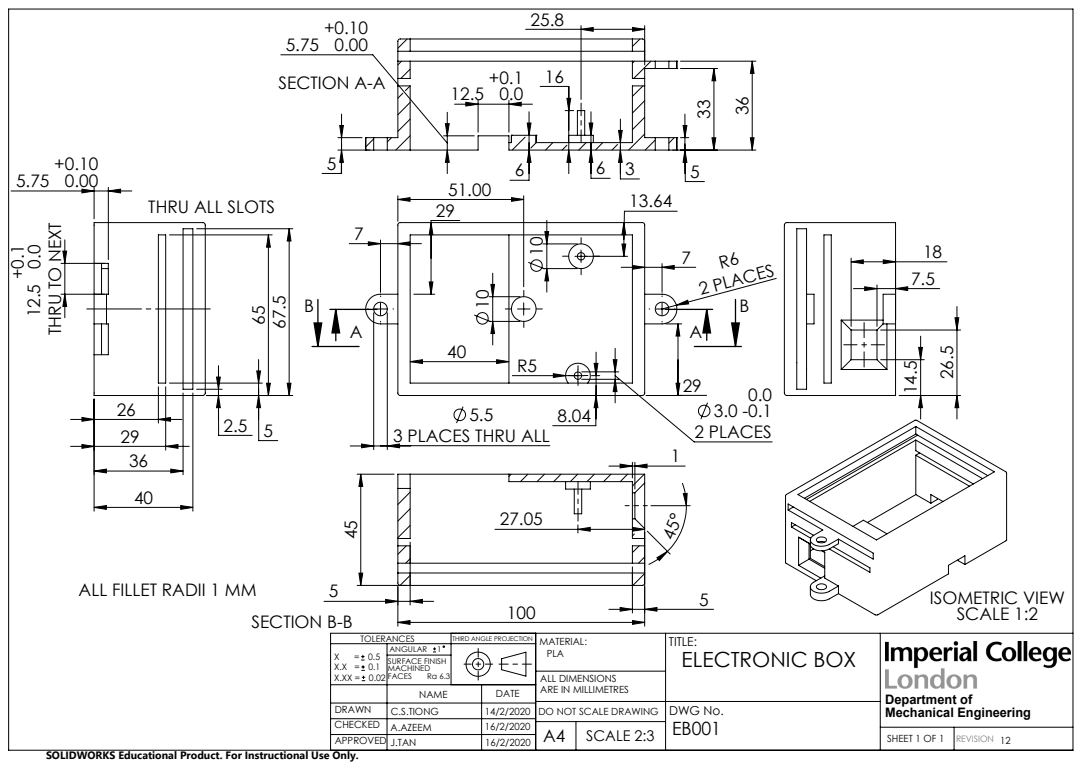
[picture p90: page 1]
3.0 - 2 PLACES; 7 R6 2 PLACES; SECTION A-A; ISOMETRIC VIEW SCALE 1:2; SECTION B-B; SURFACE FINISH; FACES; ANGULAR 1; ELECTRONIC BOX; DWG No.; A4 SCALE 2:3; SHEET 1 OF 1; REVISION 12; Department of Mechanical Engineering

THRU ALL SLOTS

THRU TO NEXT

3 PLACES THRU ALL

ALL FILLET RADII 1 MM

THIRD ANGLE PROJECTION

MATERIAL:
PLA
ALL DIMENSIONS
ARE IN MILLIMETRES
DO NOT SCALE DRAWING

SOLIDWORKS Educational Product. For Instructional Use Only.
