DynoScan3D/DynoScan3D/Drawings/Electronic Box Cover.PDF

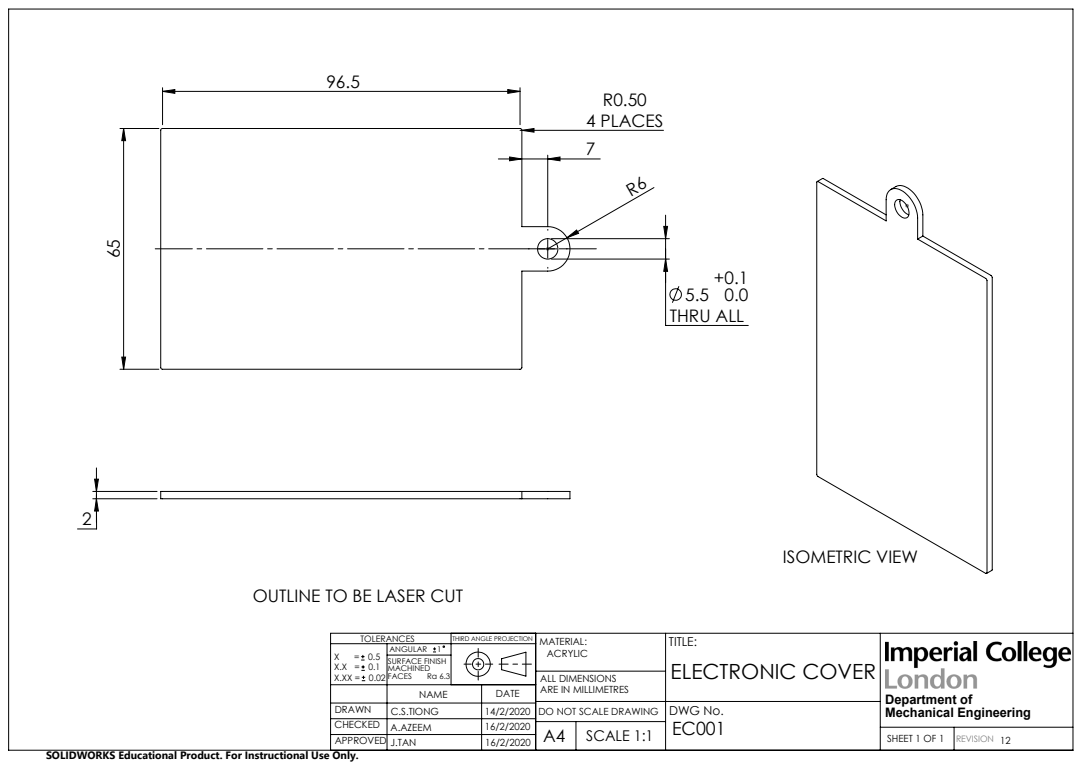
[picture p91: page 1]
THRU ALL; 4 PLACES; ISOMETRIC VIEW; SURFACE FINISH; FACES; ANGULAR 1; ELECTRONIC COVER; DWG No.; A4 SCALE 1:1; SHEET 1 OF 1; REVISION 12; Department of Mechanical Engineering

OUTLINE TO BE LASER CUT

THIRD ANGLE PROJECTION

MATERIAL:
ACRYLIC
ALL DIMENSIONS
ARE IN MILLIMETRES
DO NOT SCALE DRAWING

SOLIDWORKS Educational Product. For Instructional Use Only.
