DynoScan3D/DynoScan3D/Drawings/Frame Sub-assembly.PDF

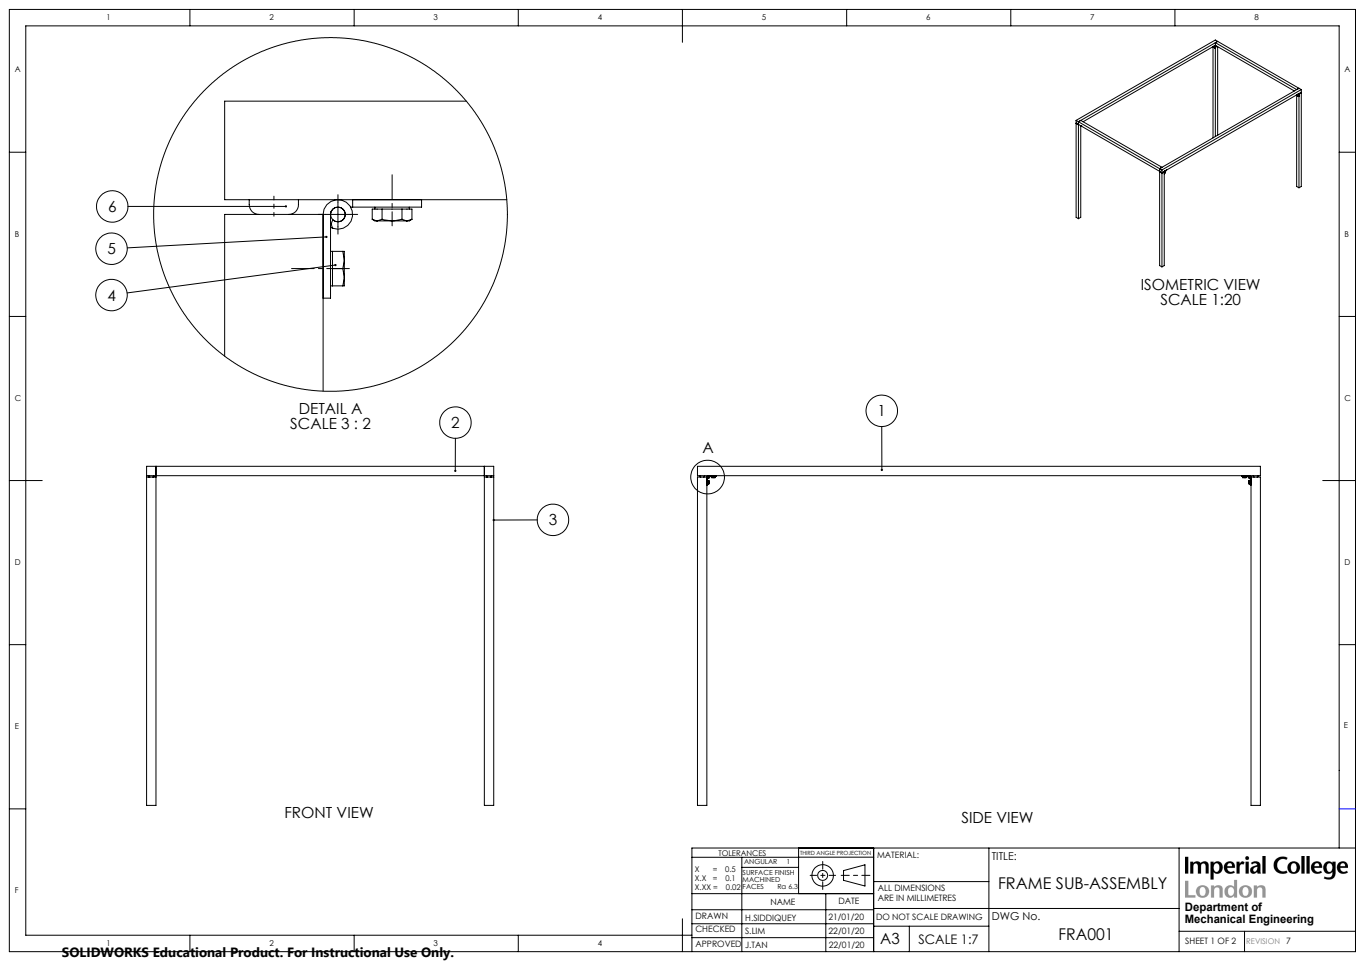
[picture p92: page 1]
ISOMETRIC VIEW SCALE 1:20; FRONT VIEW; SIDE VIEW; DETAIL A SCALE 3 : 2; SURFACE FINISH; FACES; ANGULAR 1; DWG No.; A3 SCALE 1:7; SHEET 1 OF 2; REVISION 7; Department of Mechanical Engineering

THIRD ANGLE PROJECTION

TITLE:
FRAME SUB-ASSEMBLY

ALL DIMENSIONS
ARE IN MILLIMETRES
DO NOT SCALE DRAWING

SOLIDWORKS Educational Product. For Instructional Use Only.

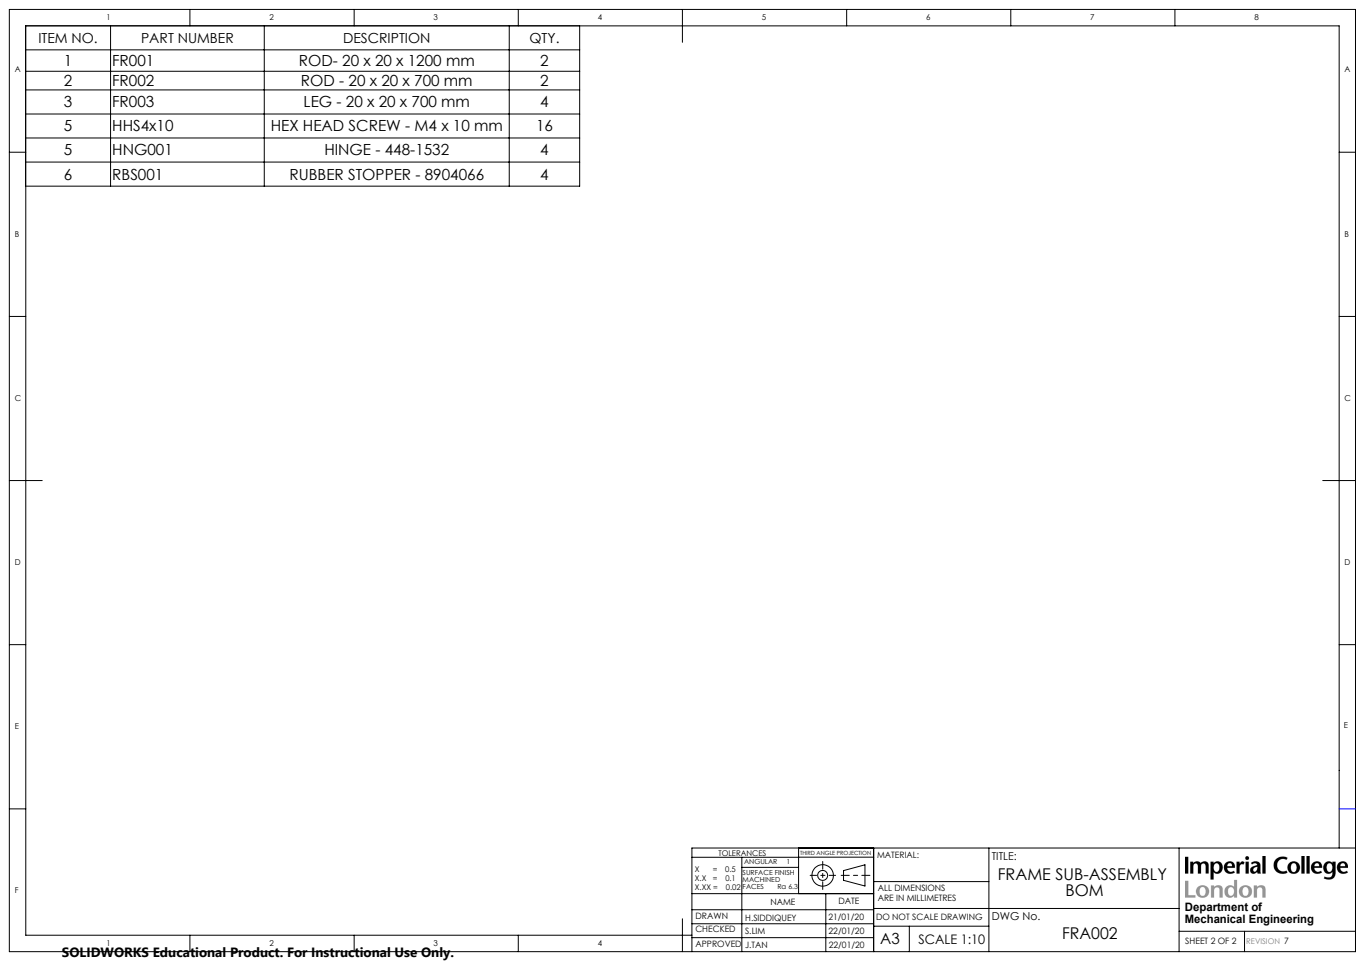
[picture p93: page 2]
SURFACE FINISH; FACES; ANGULAR 1; DWG No.; A3 SCALE 1:10; SHEET 2 OF 2; REVISION 7; Department of Mechanical Engineering

ITEM NO. | PART NUMBER | DESCRIPTION | QTY.
1 | FR001 | ROD- 20 x 20 x 1200 mm | 2
2 | FR002 | ROD - 20 x 20 x 700 mm | 2
3 | FR003 | LEG - 20 x 20 x 700 mm | 4
5 | HHS4x10 | HEX HEAD SCREW - M4 x 10 mm | 16
5 | HNG001 | HINGE - 448-1532 | 4
6 | RBS001 | RUBBER STOPPER - 8904066 | 4

THIRD ANGLE PROJECTION

TITLE:
FRAME SUB-ASSEMBLY

ALL DIMENSIONS
ARE IN MILLIMETRES
DO NOT SCALE DRAWING

SOLIDWORKS Educational Product. For Instructional Use Only.
