DynoScan3D/DynoScan3D/Drawings/Base Plate.PDF

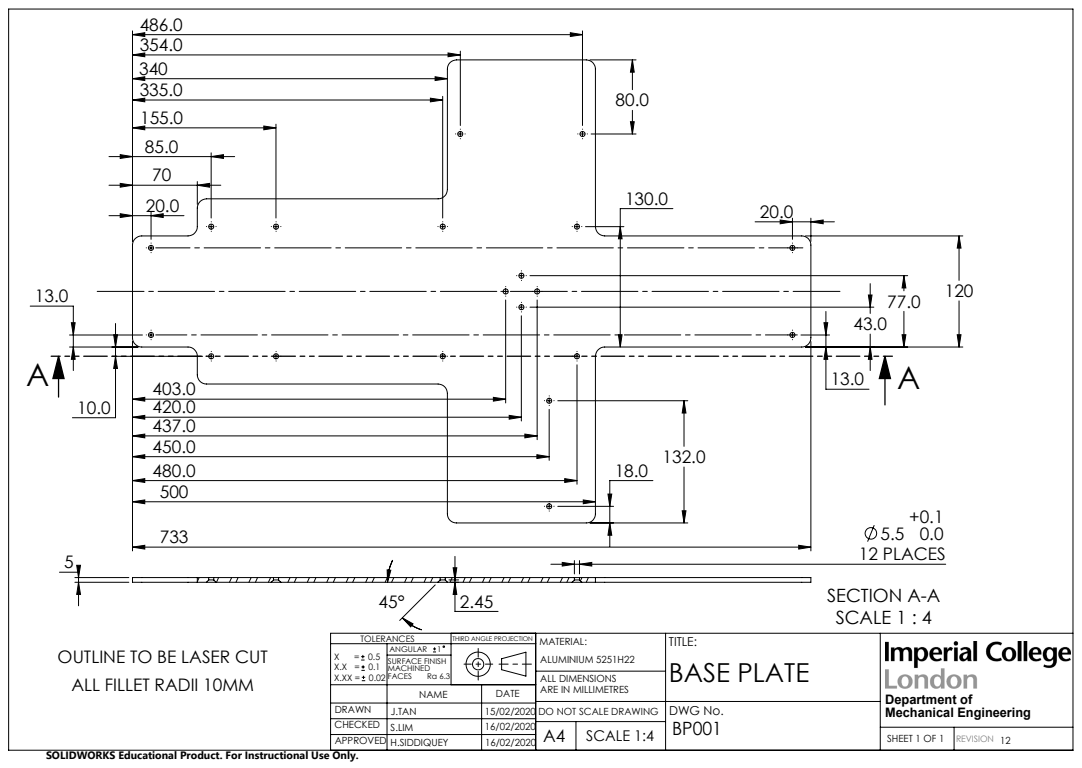
[picture p94: page 1]
12 PLACES; SECTION A-A; SCALE 1 : 4; SURFACE FINISH; FACES; ANGULAR 1; BASE PLATE; DWG No.; A4 SCALE 1:4; SHEET 1 OF 1; REVISION 12; Department of Mechanical Engineering

THIRD ANGLE PROJECTION

MATERIAL:
ALUMINIUM 5251H22
ALL DIMENSIONS
ARE IN MILLIMETRES
DO NOT SCALE DRAWING

OUTLINE TO BE LASER CUT
ALL FILLET RADII 10MM

SOLIDWORKS Educational Product. For Instructional Use Only.
