DynoScan3D/DynoScan3D/Drawings/Bearing Cap.PDF

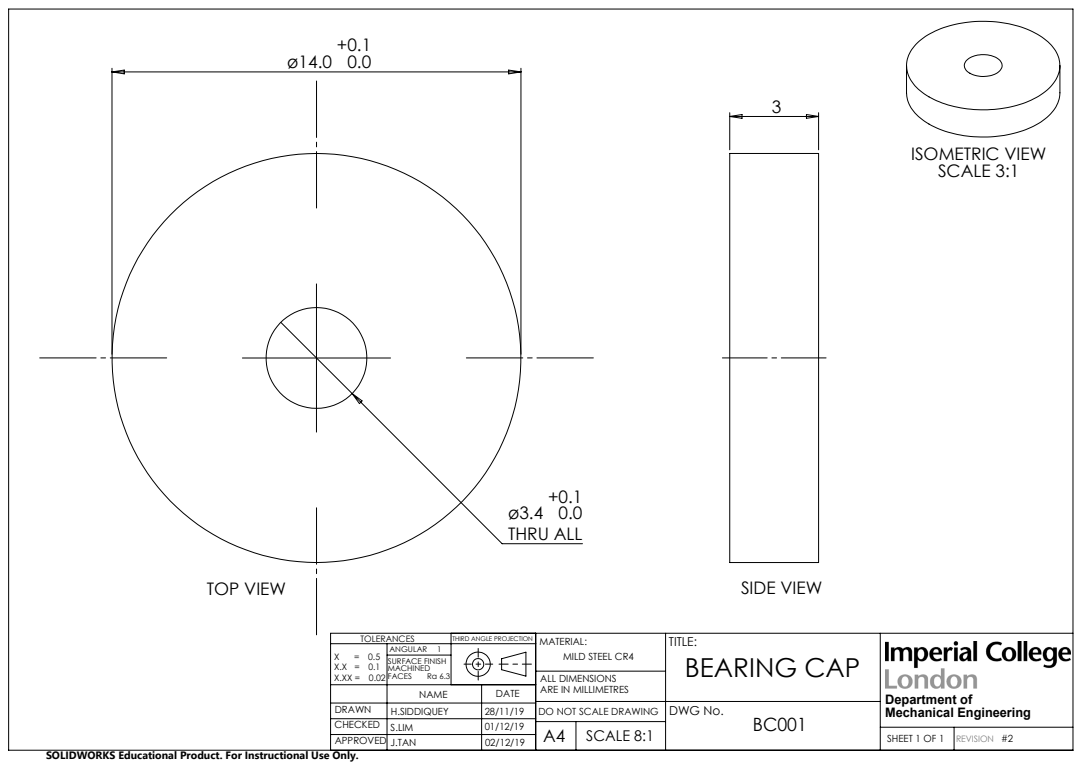
[picture p95: page 1]
THRU ALL; TOP VIEW; SIDE VIEW; ISOMETRIC VIEW SCALE 3:1; SURFACE FINISH; FACES; ANGULAR 1; BEARING CAP; DWG No.; A4 SCALE 8:1; SHEET 1 OF 1; REVISION #2; Department of Mechanical Engineering

THIRD ANGLE PROJECTION

MATERIAL:
MILD STEEL CR4
ALL DIMENSIONS
ARE IN MILLIMETRES
DO NOT SCALE DRAWING

SOLIDWORKS Educational Product. For Instructional Use Only.
