DynoScan3D/DynoScan3D/Drawings/Bearing Housing Bottom.PDF

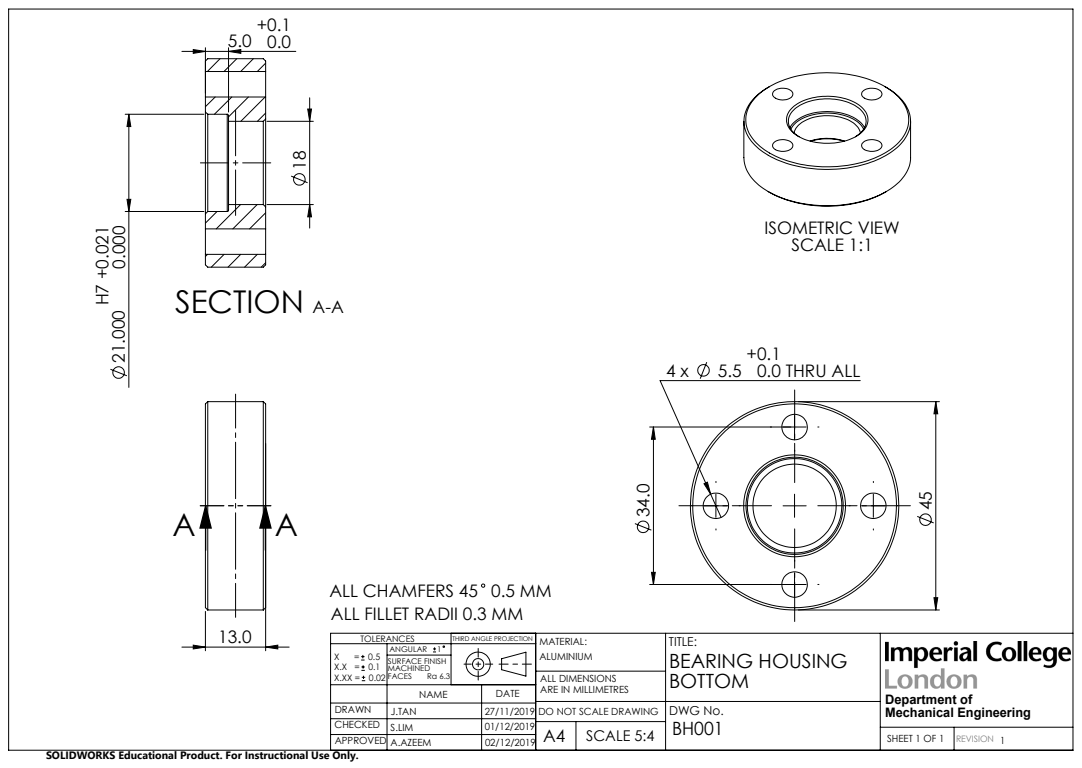
[picture p96: page 1]
0.0 THRU ALL; SECTION A-A; ISOMETRIC VIEW SCALE 1:1; SURFACE FINISH; FACES; ANGULAR 1; BEARING HOUSING; DWG No.; A4 SCALE 5:4; SHEET 1 OF 1; REVISION 1; Department of Mechanical Engineering

ALL CHAMFERS 45 0.5 MM
ALL FILLET RADII 0.3 MM

THIRD ANGLE PROJECTION

MATERIAL:
ALUMINIUM
ALL DIMENSIONS
ARE IN MILLIMETRES
DO NOT SCALE DRAWING

SOLIDWORKS Educational Product. For Instructional Use Only.
