DynoScan3D/DynoScan3D/Drawings/Bearing Housing Lid.PDF

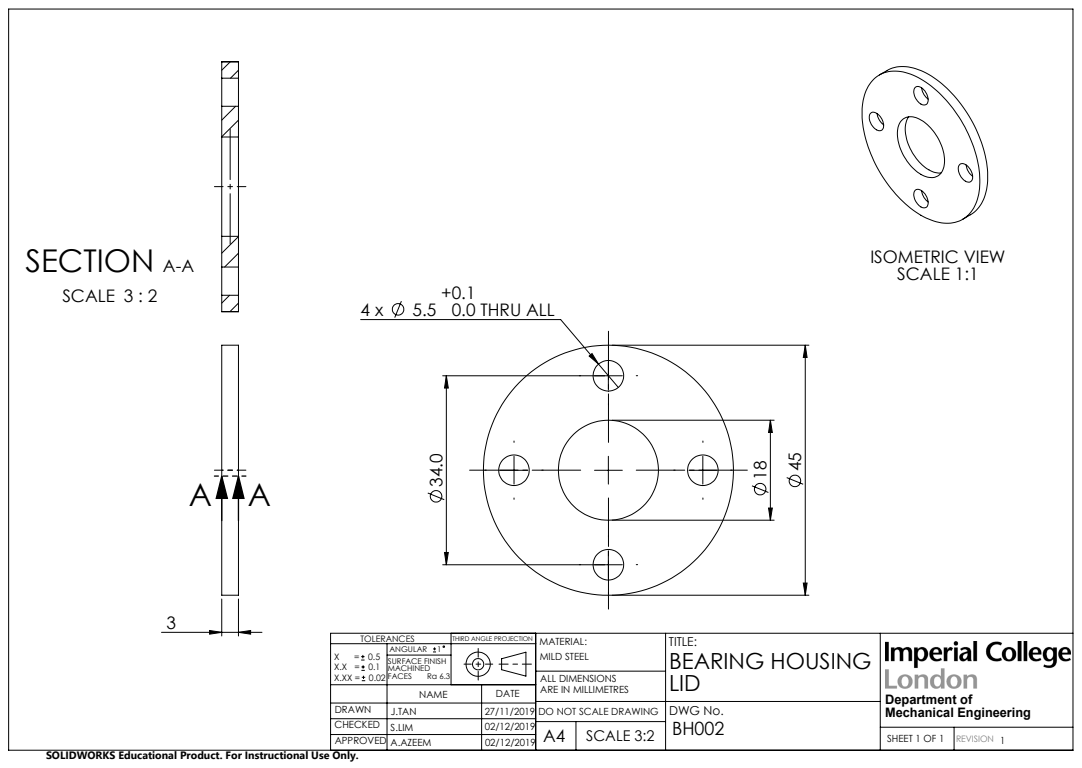
[picture p97: page 1]
0.0 THRU ALL; ISOMETRIC VIEW; SCALE 1:1 SECTION A-A; SCALE 3 : 2; SURFACE FINISH; FACES; ANGULAR 1; BEARING HOUSING; DWG No.; A4 SCALE 3:2; SHEET 1 OF 1; REVISION 1; Department of Mechanical Engineering

THIRD ANGLE PROJECTION

MATERIAL:
MILD STEEL
ALL DIMENSIONS
ARE IN MILLIMETRES
DO NOT SCALE DRAWING

SOLIDWORKS Educational Product. For Instructional Use Only.
