DynoScan3D/DynoScan3D/Drawings/Converter Box Cover.PDF

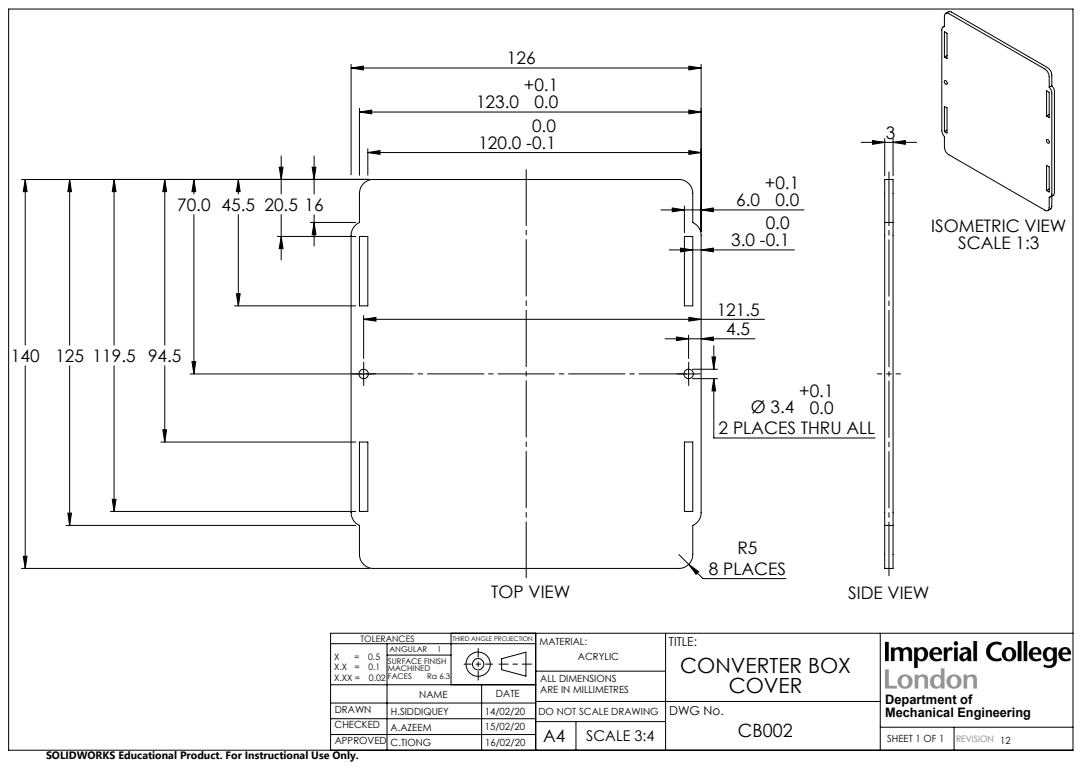
[picture p98: page 1]
8 PLACES; TOP VIEW; ISOMETRIC VIEW SCALE 1:3; SIDE VIEW; SURFACE FINISH; FACES; ANGULAR 1; CONVERTER BOX; DWG No.; A4 SCALE 3:4; SHEET 1 OF 1; REVISION 12; Department of Mechanical Engineering

2 PLACES THRU ALL

THIRD ANGLE PROJECTION

MATERIAL:
ACRYLIC
ALL DIMENSIONS
ARE IN MILLIMETRES
DO NOT SCALE DRAWING

SOLIDWORKS Educational Product. For Instructional Use Only.
