DynoScan3D/DynoScan3D/Drawings/Idler Shaft.PDF

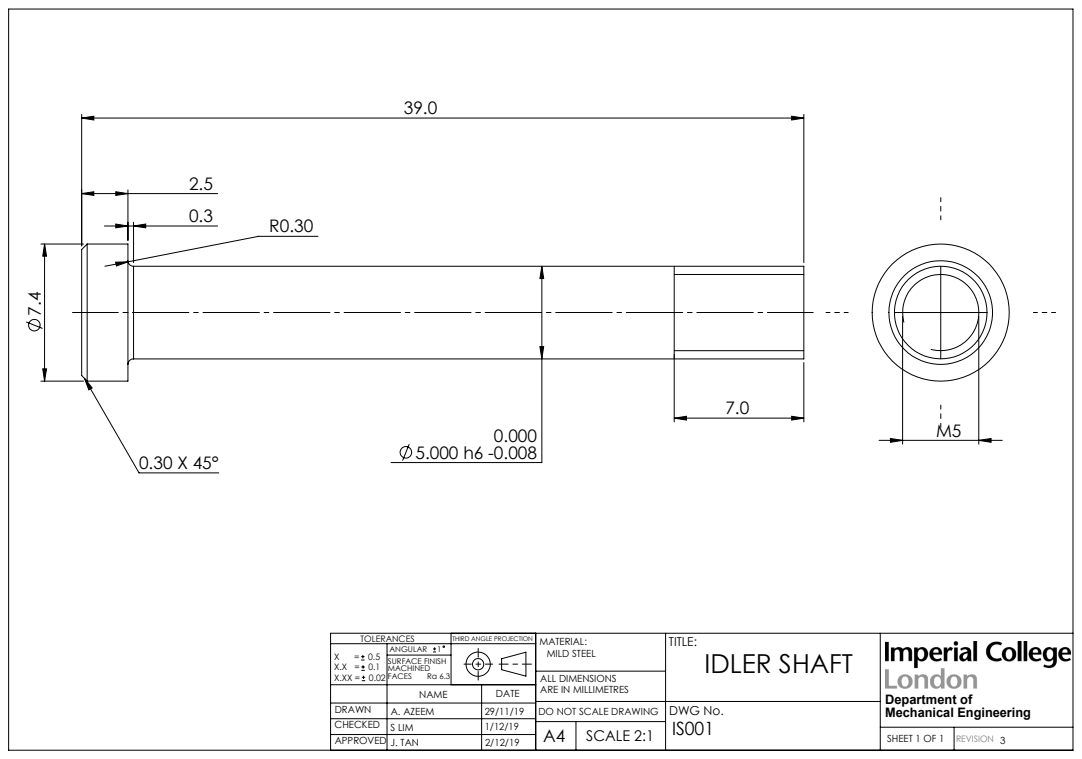
[picture p99: page 1]
SURFACE FINISH; FACES; ANGULAR 1; IDLER SHAFT; DWG No.; A4 SCALE 2:1; SHEET 1 OF 1; A. AZEEM S LIM J. TAN; REVISION 3; Department of Mechanical Engineering

THIRD ANGLE PROJECTION

MATERIAL:
MILD STEEL
ALL DIMENSIONS
ARE IN MILLIMETRES
DO NOT SCALE DRAWING
