DynoScan3D/DynoScan3D/Drawings/Idler Spacer.PDF

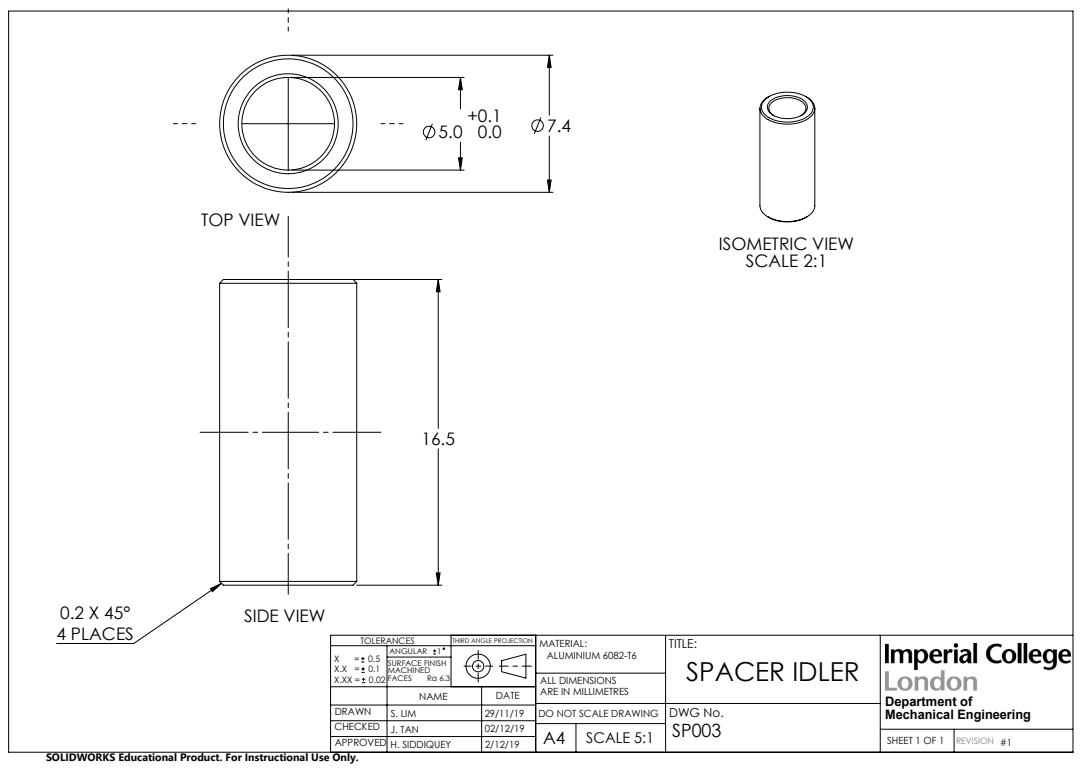
[picture p100: page 1]
0.2 X 45° 4 PLACES; SIDE VIEW; TOP VIEW; ISOMETRIC VIEW SCALE 2:1; SURFACE FINISH; FACES; ANGULAR 1; SPACER IDLER; DWG No.; A4 SCALE 5:1; SHEET 1 OF 1; S. LIM J. TAN H. SIDDIQUEY; REVISION #1; Department of Mechanical Engineering

THIRD ANGLE PROJECTION

MATERIAL:
ALUMINIUM 6082-T6
ALL DIMENSIONS
ARE IN MILLIMETRES
DO NOT SCALE DRAWING

SOLIDWORKS Educational Product. For Instructional Use Only.
