DynoScan3D/DynoScan3D/Drawings/Intermediate Pillar.PDF

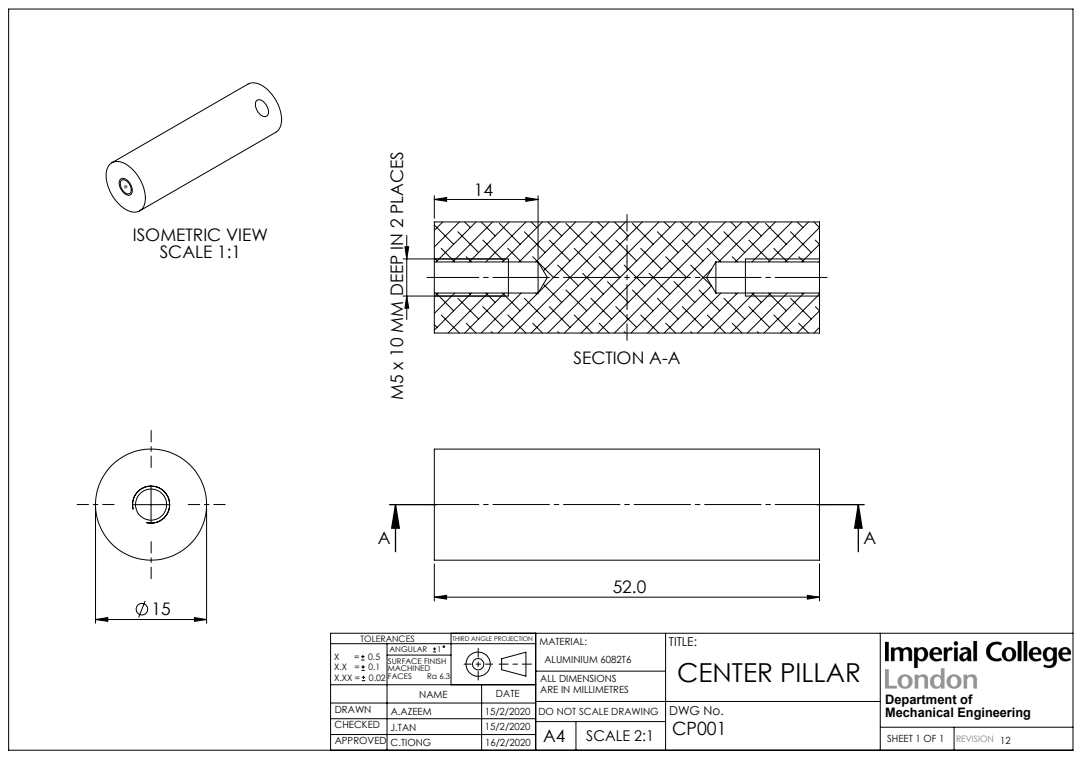
[picture p101: page 1]
SECTION A-A; ISOMETRIC VIEW SCALE 1:1; SURFACE FINISH; FACES; ANGULAR 1; CENTER PILLAR; DWG No.; A4 SCALE 2:1; SHEET 1 OF 1; REVISION 12; Department of Mechanical Engineering

M5 x 10 MM DEEP IN 2 PLACES

THIRD ANGLE PROJECTION

MATERIAL:
ALUMINIUM 6082T6
ALL DIMENSIONS
ARE IN MILLIMETRES
DO NOT SCALE DRAWING
