DynoScan3D/DynoScan3D/Drawings/Intermediate Platform.PDF

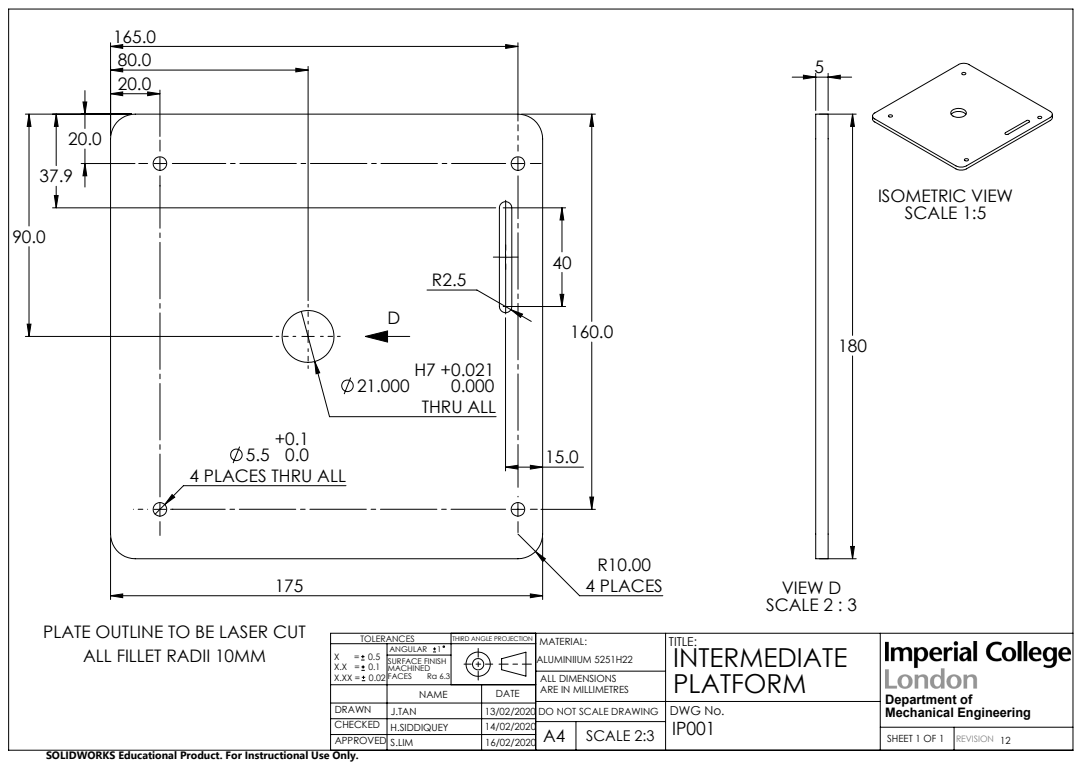
[picture p102: page 1]
THRU ALL; 4 PLACES; VIEW D SCALE 2 : 3; ISOMETRIC VIEW SCALE 1:5; ALL FILLET RADII 10MM; SURFACE FINISH; FACES; ANGULAR 1; DWG No.; A4 SCALE 2:3; SHEET 1 OF 1; REVISION 12; Department of Mechanical Engineering

4 PLACES THRU ALL

PLATE OUTLINE TO BE LASER CUT

THIRD ANGLE PROJECTION

MATERIAL:
ALUMINIIUM 5251H22
ALL DIMENSIONS
ARE IN MILLIMETRES
DO NOT SCALE DRAWING

SOLIDWORKS Educational Product. For Instructional Use Only.
