DynoScan3D/DynoScan3D/Drawings/Main Shaft.PDF

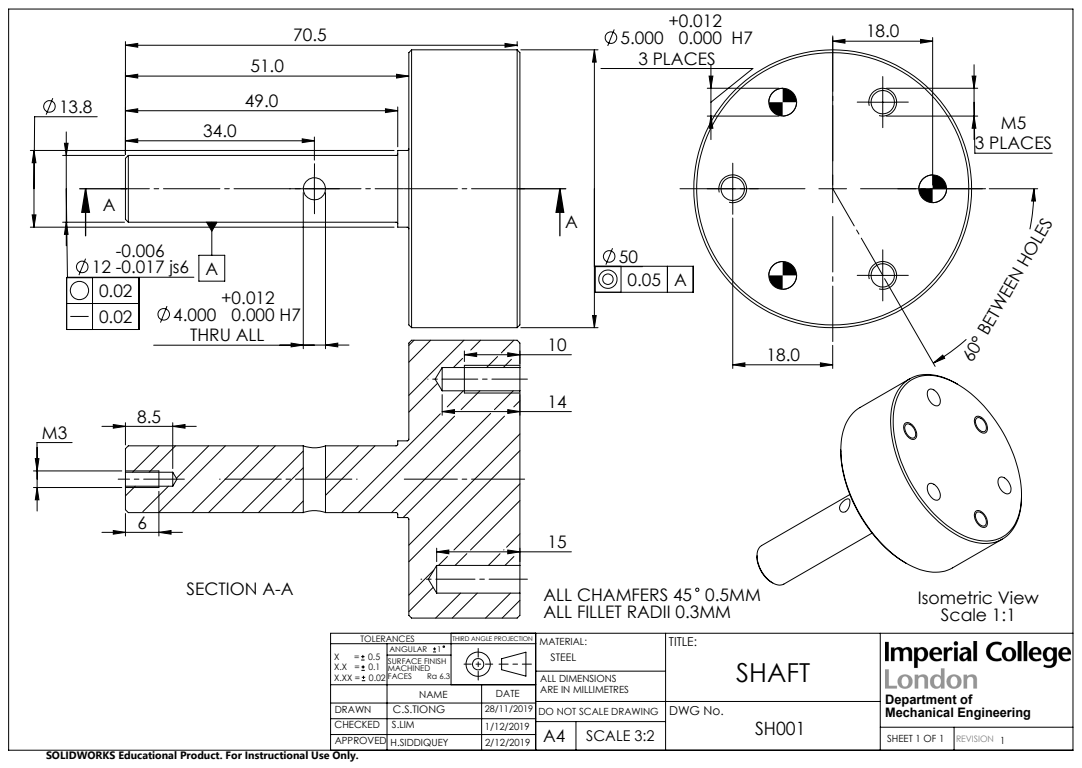
[picture p103: page 1]
Isometric View Scale 1:1; 0.000 H7 THRU ALL; 0.000 H7 3 PLACES; 3 PLACES; 60° BETWEEN HOLES; SECTION A-A; ALL CHAMFERS 45 0.5MM; SURFACE FINISH; FACES; ANGULAR 1; DWG No.; A4 SCALE 3:2; SHEET 1 OF 1; REVISION 1; Department of Mechanical Engineering

0.02

ALL FILLET RADII 0.3MM

THIRD ANGLE PROJECTION

MATERIAL:
STEEL
ALL DIMENSIONS
ARE IN MILLIMETRES
DO NOT SCALE DRAWING

SOLIDWORKS Educational Product. For Instructional Use Only.
