DynoScan3D/DynoScan3D/Drawings/Motor Plate.PDF

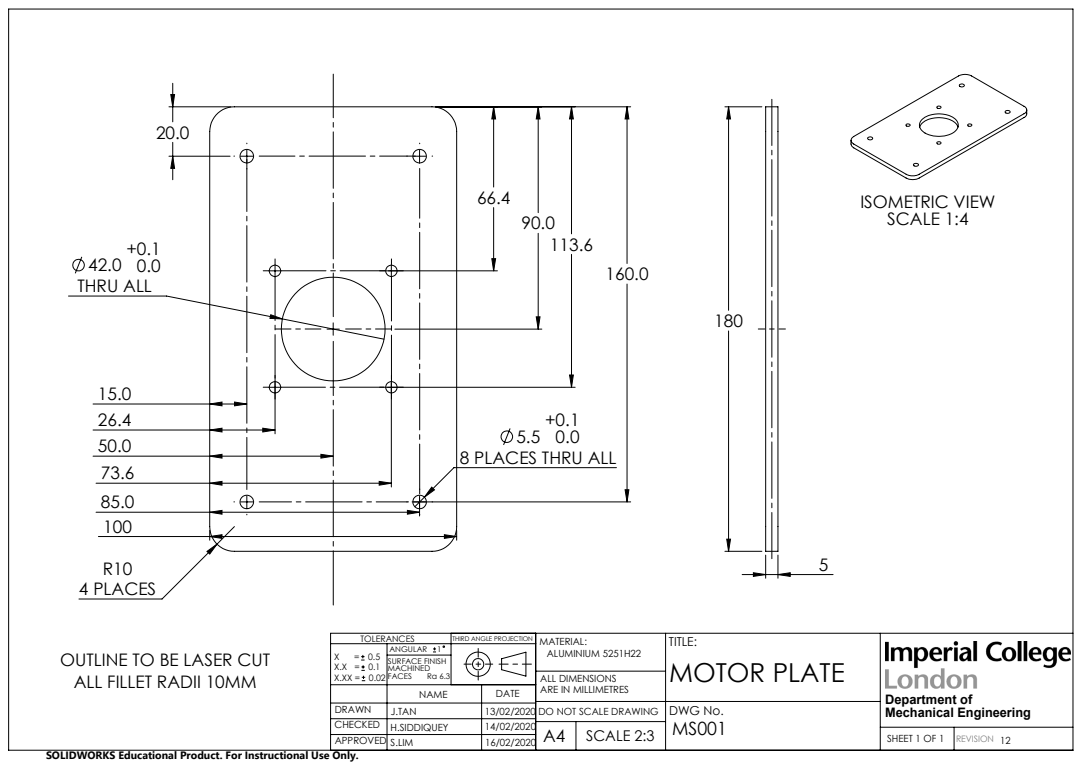
[picture p104: page 1]
THRU ALL; 4 PLACES; ISOMETRIC VIEW SCALE 1:4; SURFACE FINISH; FACES; ANGULAR 1; MOTOR PLATE; DWG No.; A4 SCALE 2:3; SHEET 1 OF 1; REVISION 12; Department of Mechanical Engineering

8 PLACES THRU ALL

THIRD ANGLE PROJECTION

MATERIAL:
ALUMINIUM 5251H22
ALL DIMENSIONS
ARE IN MILLIMETRES
DO NOT SCALE DRAWING

OUTLINE TO BE LASER CUT
ALL FILLET RADII 10MM

SOLIDWORKS Educational Product. For Instructional Use Only.
