DynoScan3D/DynoScan3D/Drawings/Motor Pulley.PDF

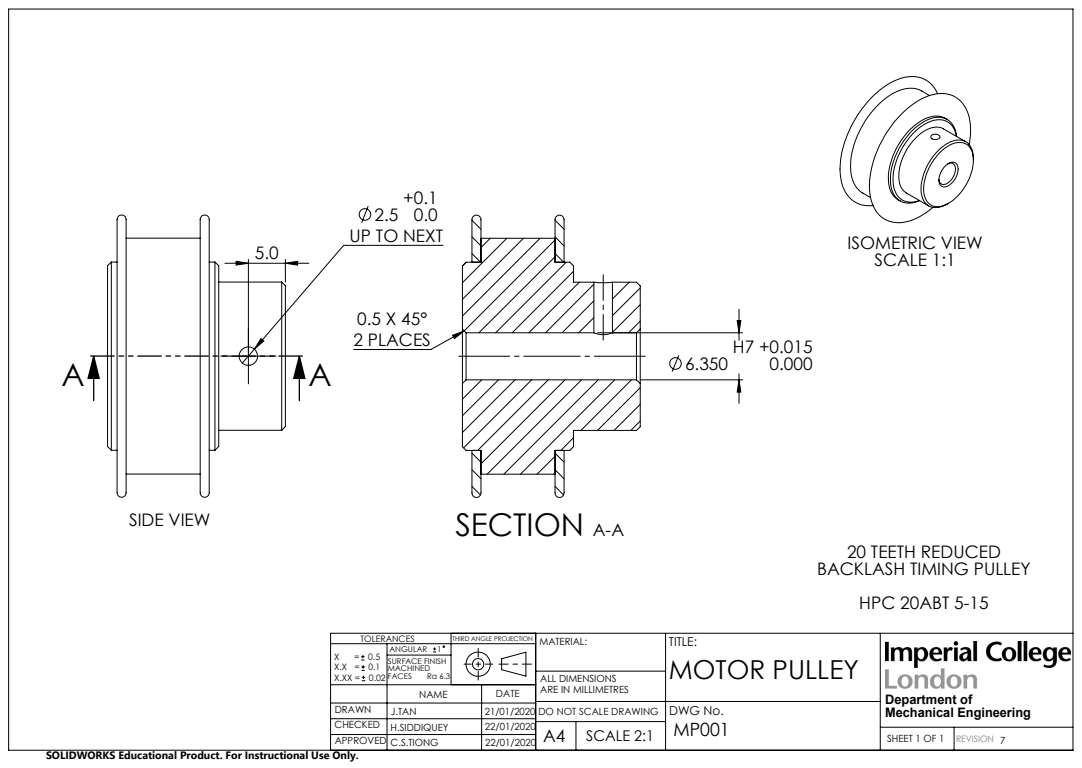
[picture p105: page 1]
UP TO NEXT; 0.5 X 45° 2 PLACES; SECTION A-A; ISOMETRIC VIEW SCALE 1:1; SIDE VIEW; SURFACE FINISH; FACES; ANGULAR 1; MOTOR PULLEY; DWG No.; A4 SCALE 2:1; SHEET 1 OF 1; REVISION 7; Department of Mechanical Engineering

20 TEETH REDUCED
BACKLASH TIMING PULLEY
HPC 20ABT 5-15

THIRD ANGLE PROJECTION

ALL DIMENSIONS
ARE IN MILLIMETRES
DO NOT SCALE DRAWING

SOLIDWORKS Educational Product. For Instructional Use Only.
