DynoScan3D/DynoScan3D/Drawings/Projector Slider.PDF

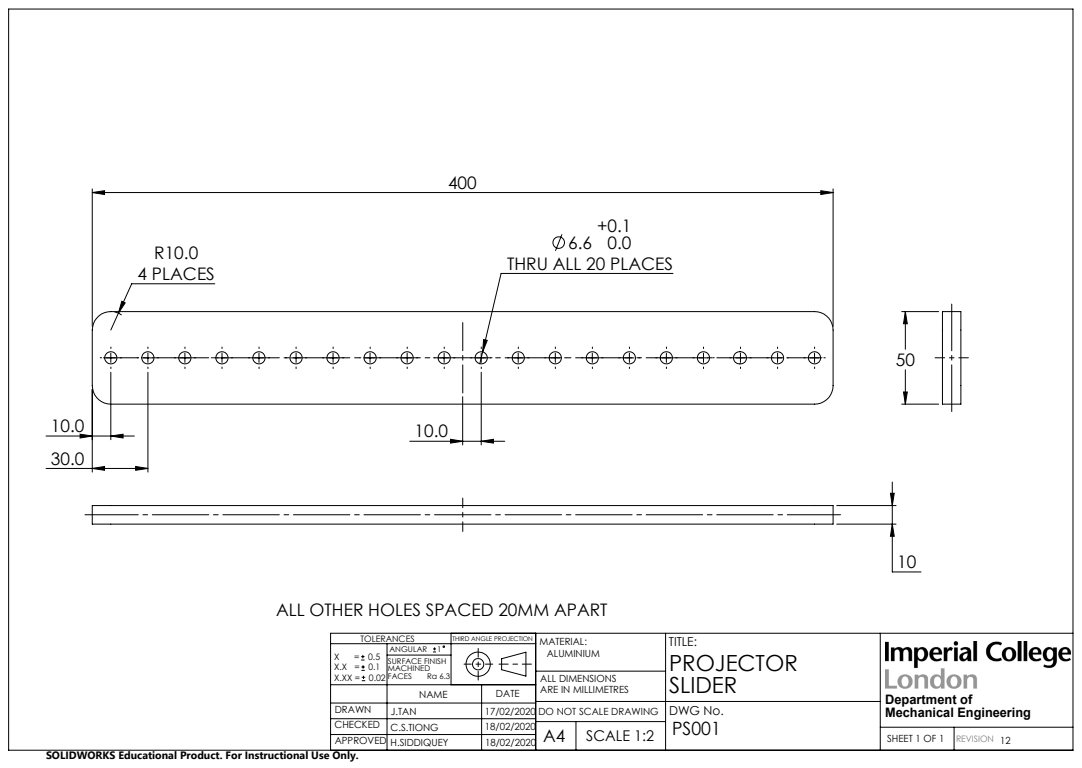
[picture p106: page 1]
SURFACE FINISH; FACES; ANGULAR 1; DWG No.; A4 SCALE 1:2; SHEET 1 OF 1; REVISION 12; Department of Mechanical Engineering

THRU ALL 20 PLACES R10.0
4 PLACES

ALL OTHER HOLES SPACED 20MM APART

THIRD ANGLE PROJECTION

MATERIAL:
ALUMINIUM
ALL DIMENSIONS
ARE IN MILLIMETRES
DO NOT SCALE DRAWING

SOLIDWORKS Educational Product. For Instructional Use Only.
