DynoScan3D/DynoScan3D/Drawings/Rod 0.7m.PDF

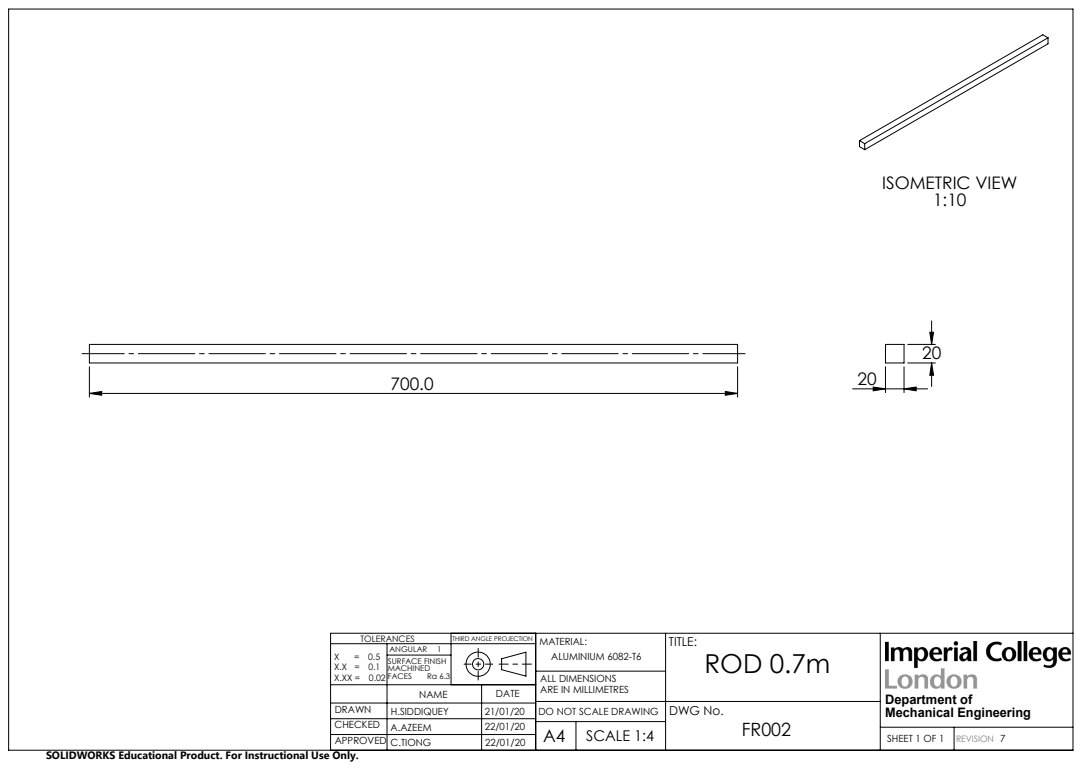
[picture p107: page 1]
ISOMETRIC VIEW; SURFACE FINISH; FACES; ANGULAR 1; ROD 0.7m; DWG No.; A4 SCALE 1:4; SHEET 1 OF 1; REVISION 7; Department of Mechanical Engineering

THIRD ANGLE PROJECTION

MATERIAL:
ALUMINIUM 6082-T6
ALL DIMENSIONS
ARE IN MILLIMETRES
DO NOT SCALE DRAWING

SOLIDWORKS Educational Product. For Instructional Use Only.
