DynoScan3D/DynoScan3D/Drawings/Rod 1.2m.PDF

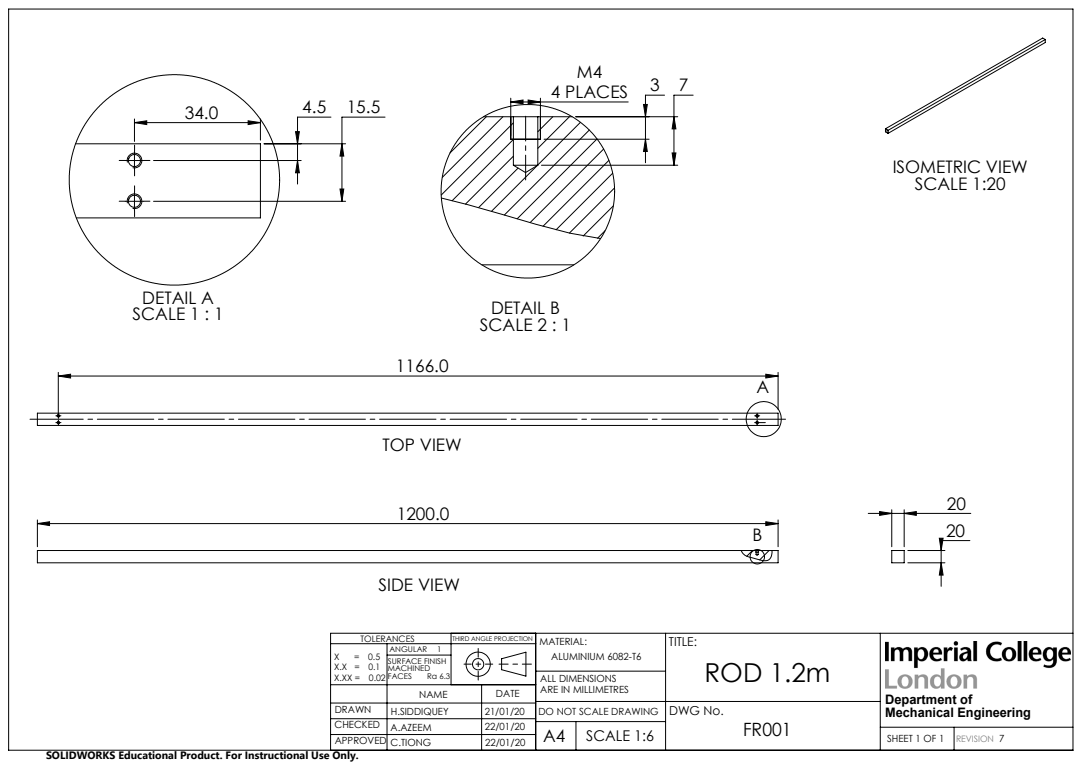
[picture p108: page 1]
TOP VIEW; SIDE VIEW; ISOMETRIC VIEW SCALE 1:20; DETAIL A SCALE 1 : 1; 4 PLACES 3; DETAIL B SCALE 2 : 1; SURFACE FINISH; FACES; ANGULAR 1; ROD 1.2m; DWG No.; A4 SCALE 1:6; SHEET 1 OF 1; REVISION 7; Department of Mechanical Engineering

THIRD ANGLE PROJECTION

MATERIAL:
ALUMINIUM 6082-T6
ALL DIMENSIONS
ARE IN MILLIMETRES
DO NOT SCALE DRAWING

SOLIDWORKS Educational Product. For Instructional Use Only.
