DynoScan3D/DynoScan3D/Drawings/Transmission Cover - Motor.PDF

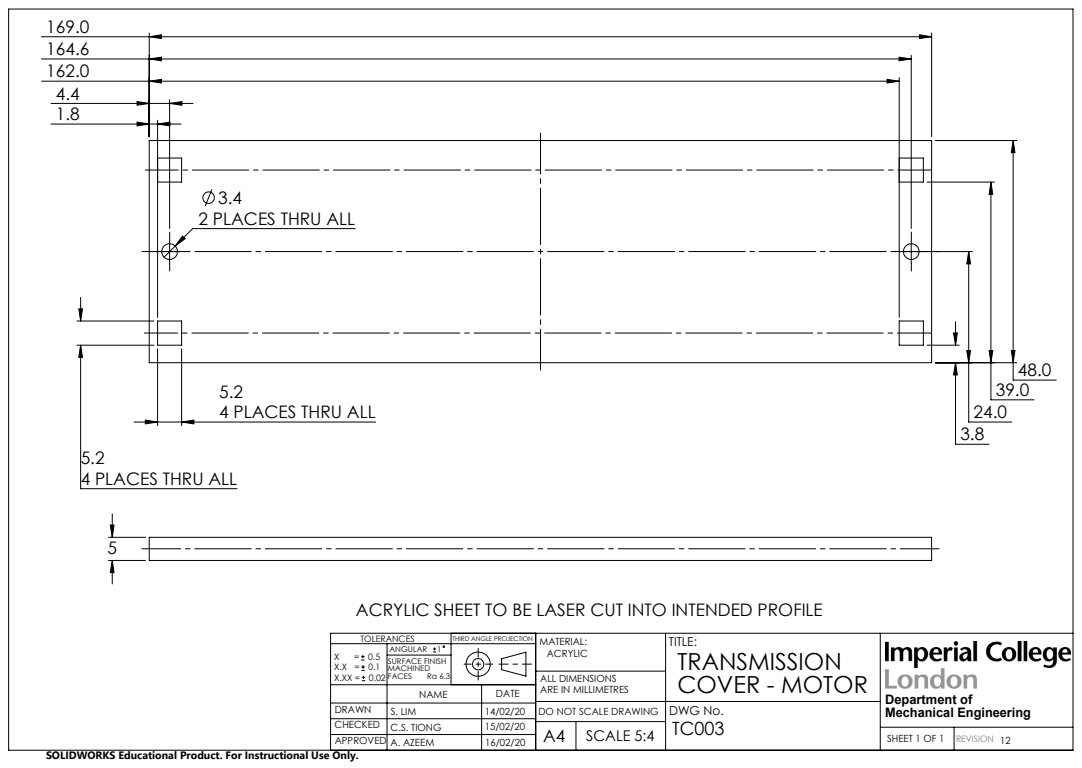
[picture p109: page 1]
SURFACE FINISH; FACES; ANGULAR 1; COVER - MOTOR; DWG No.; A4 SCALE 5:4; SHEET 1 OF 1; S. LIM C.S. TIONG A. AZEEM; REVISION 12; Department of Mechanical Engineering

2 PLACES THRU ALL

4 PLACES THRU ALL

ACRYLIC SHEET TO BE LASER CUT INTO INTENDED PROFILE

THIRD ANGLE PROJECTION

MATERIAL:
ACRYLIC
ALL DIMENSIONS
ARE IN MILLIMETRES
DO NOT SCALE DRAWING

SOLIDWORKS Educational Product. For Instructional Use Only.
