DynoScan3D/DynoScan3D/Drawings/Transmission Cover - Side.PDF

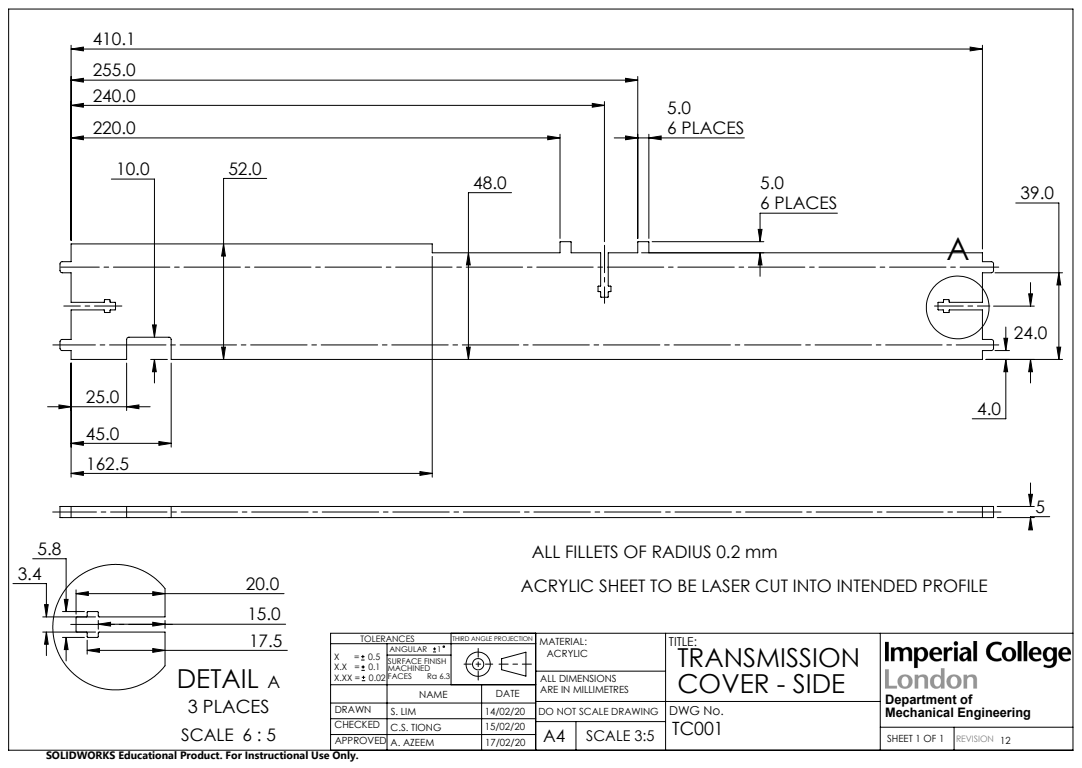
[picture p110: page 1]
6 PLACES; DETAIL A 3 PLACES SCALE 6 : 5; SURFACE FINISH; FACES; ANGULAR 1; COVER - SIDE; DWG No.; A4 SCALE 3:5; SHEET 1 OF 1; S. LIM C.S. TIONG A. AZEEM; REVISION 12; Department of Mechanical Engineering

ALL FILLETS OF RADIUS 0.2 mm
ACRYLIC SHEET TO BE LASER CUT INTO INTENDED PROFILE

THIRD ANGLE PROJECTION

MATERIAL:
ACRYLIC
ALL DIMENSIONS
ARE IN MILLIMETRES
DO NOT SCALE DRAWING

SOLIDWORKS Educational Product. For Instructional Use Only.
