DynoScan3D/DynoScan3D/Drawings/Transmission Cover - Top.PDF

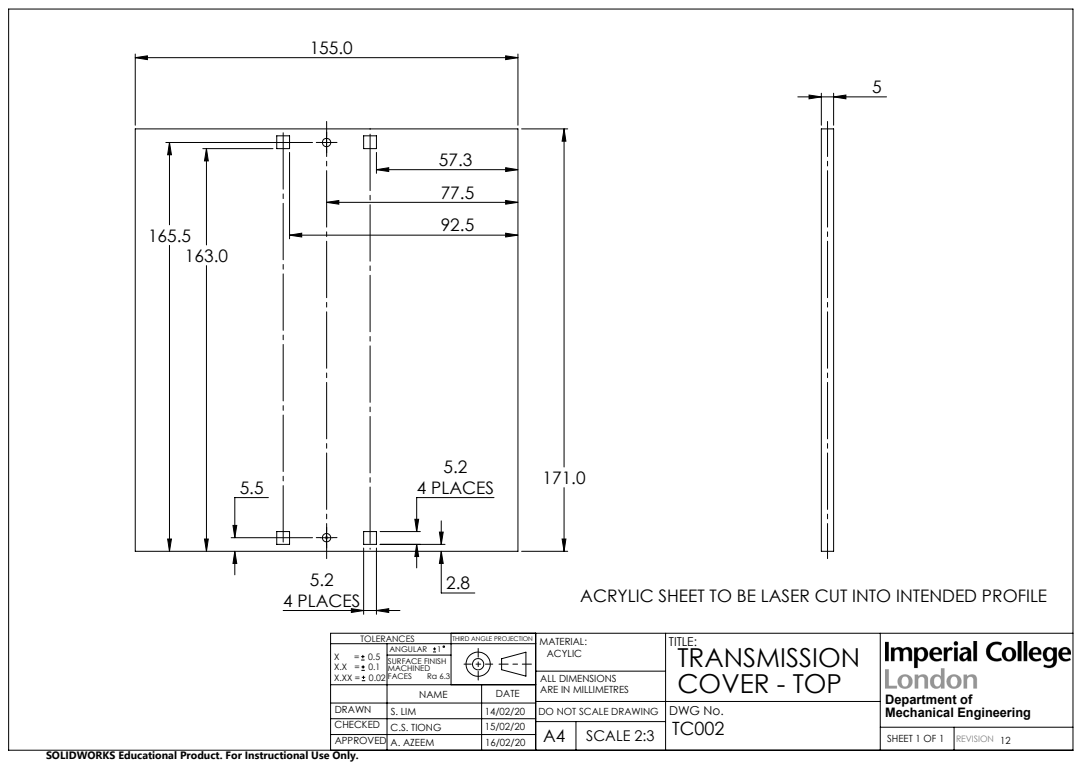
[picture p111: page 1]
171.0 5.5 4 PLACES; 4 PLACES; SURFACE FINISH; FACES; ANGULAR 1; DWG No.; A4 SCALE 2:3; SHEET 1 OF 1; S. LIM C.S. TIONG A. AZEEM; REVISION 12; Department of Mechanical Engineering

ACRYLIC SHEET TO BE LASER CUT INTO INTENDED PROFILE
TRANSMISSION
COVER - TOP

THIRD ANGLE PROJECTION

MATERIAL:
ACYLIC
ALL DIMENSIONS
ARE IN MILLIMETRES
DO NOT SCALE DRAWING

SOLIDWORKS Educational Product. For Instructional Use Only.
