DynoScan3D/DynoScan3D/Drawings/Turntable Pulley.PDF

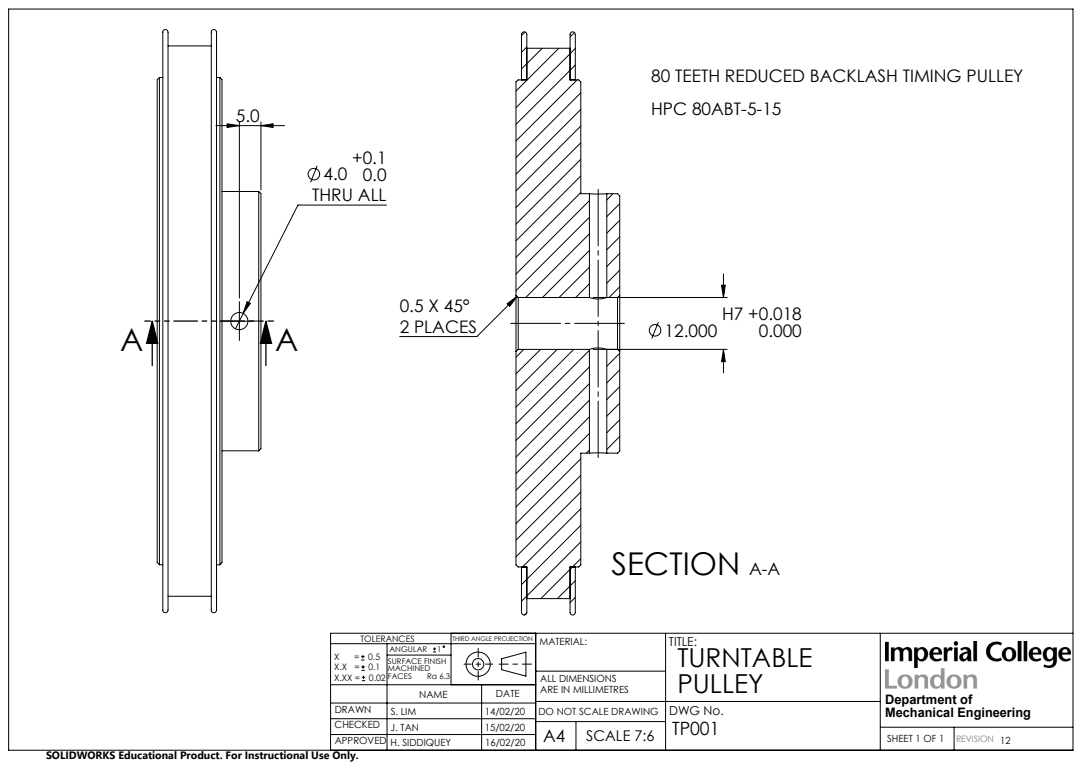
[picture p112: page 1]
THRU ALL; 0.5 X 45° 2 PLACES; SECTION A-A; SURFACE FINISH; FACES; ANGULAR 1; DWG No.; A4 SCALE 7:6; SHEET 1 OF 1; S. LIM J. TAN H. SIDDIQUEY; REVISION 12; Department of Mechanical Engineering

80 TEETH REDUCED BACKLASH TIMING PULLEY
HPC 80ABT-5-15

THIRD ANGLE PROJECTION

ALL DIMENSIONS
ARE IN MILLIMETRES
DO NOT SCALE DRAWING

SOLIDWORKS Educational Product. For Instructional Use Only.
