DynoScan3D/DynoScan3D/Drawings/Turntable.PDF

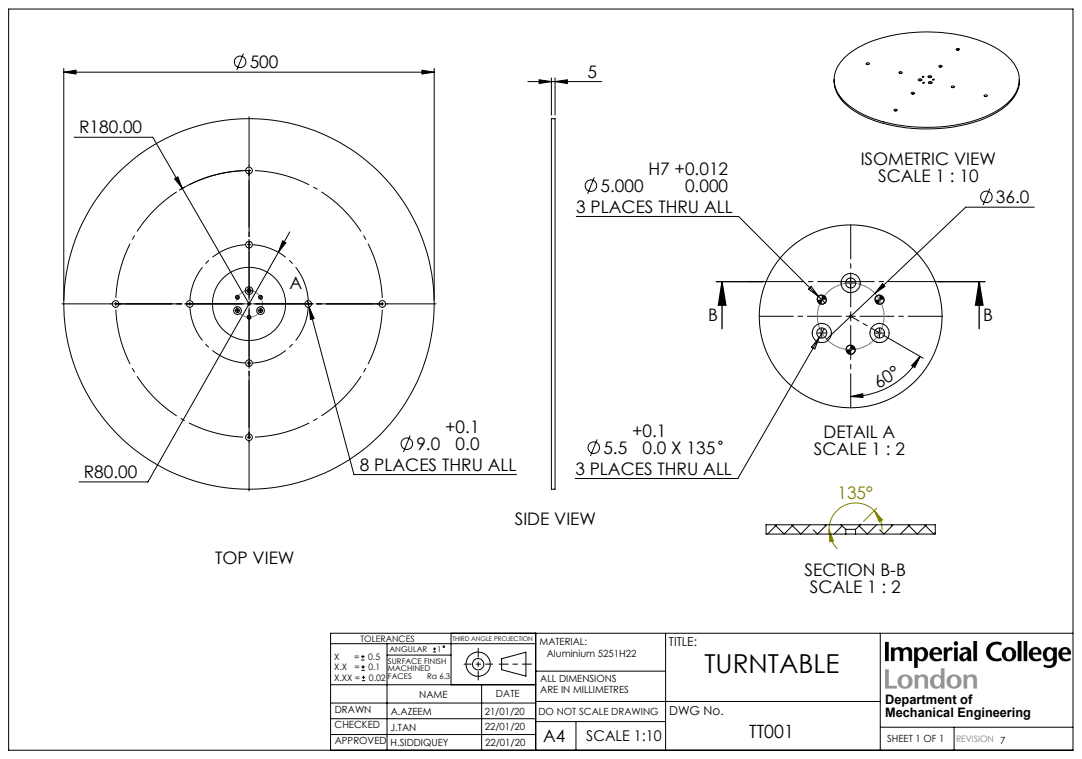
[picture p113: page 1]
3 PLACES THRU ALL; 0.0 X 135 3 PLACES THRU ALL; DETAIL A SCALE 1 : 2; SECTION B-B SCALE 1 : 2; ISOMETRIC VIEW SCALE 1 : 10; TOP VIEW; SIDE VIEW; SURFACE FINISH; FACES; ANGULAR 1; DWG No.; A4 SCALE 1:10; SHEET 1 OF 1; REVISION 7; Department of Mechanical Engineering

8 PLACES THRU ALL R80.00

THIRD ANGLE PROJECTION

MATERIAL:
Aluminium 5251H22
ALL DIMENSIONS
ARE IN MILLIMETRES
DO NOT SCALE DRAWING
