DynoScan3D/DynoScan3D/Drawings/Vertical Rod 0.7m.PDF

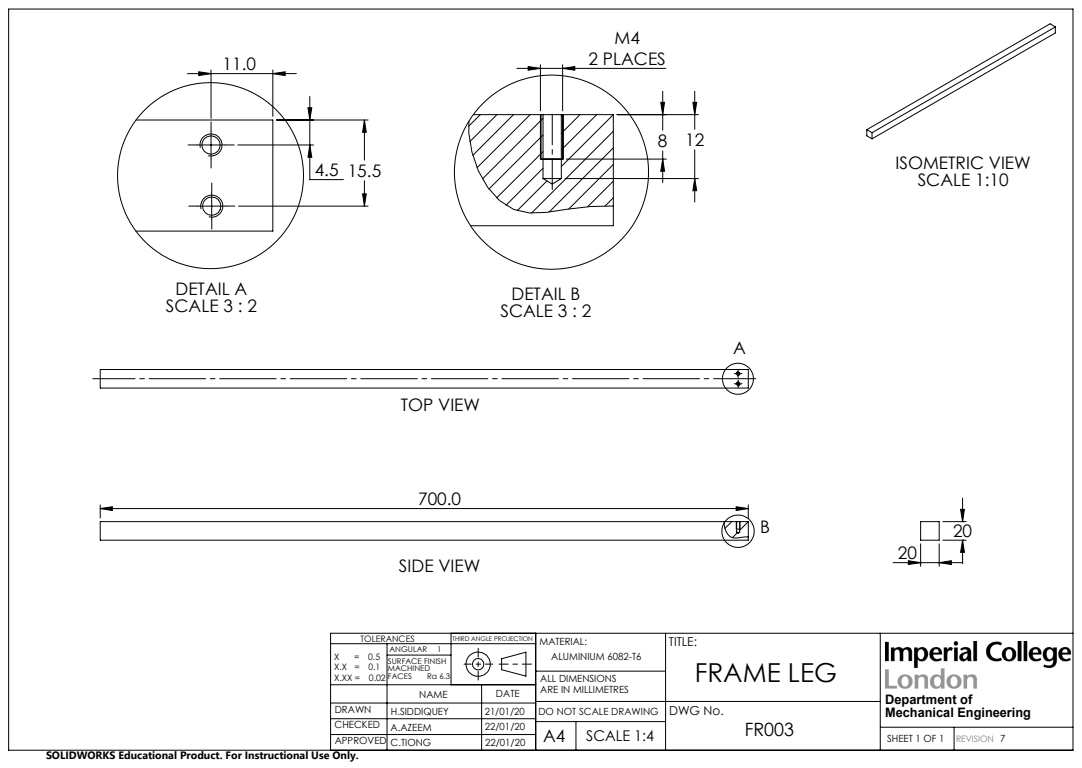
[picture p114: page 1]
TOP VIEW; SIDE VIEW; ISOMETRIC VIEW SCALE 1:10; DETAIL A SCALE 3 : 2; 2 PLACES; DETAIL B SCALE 3 : 2; SURFACE FINISH; FACES; ANGULAR 1; FRAME LEG; DWG No.; A4 SCALE 1:4; SHEET 1 OF 1; REVISION 7; Department of Mechanical Engineering

THIRD ANGLE PROJECTION

MATERIAL:
ALUMINIUM 6082-T6
ALL DIMENSIONS
ARE IN MILLIMETRES
DO NOT SCALE DRAWING

SOLIDWORKS Educational Product. For Instructional Use Only.
