DynoScan3D/DynoScan3D/Drawings/Converter Box.PDF

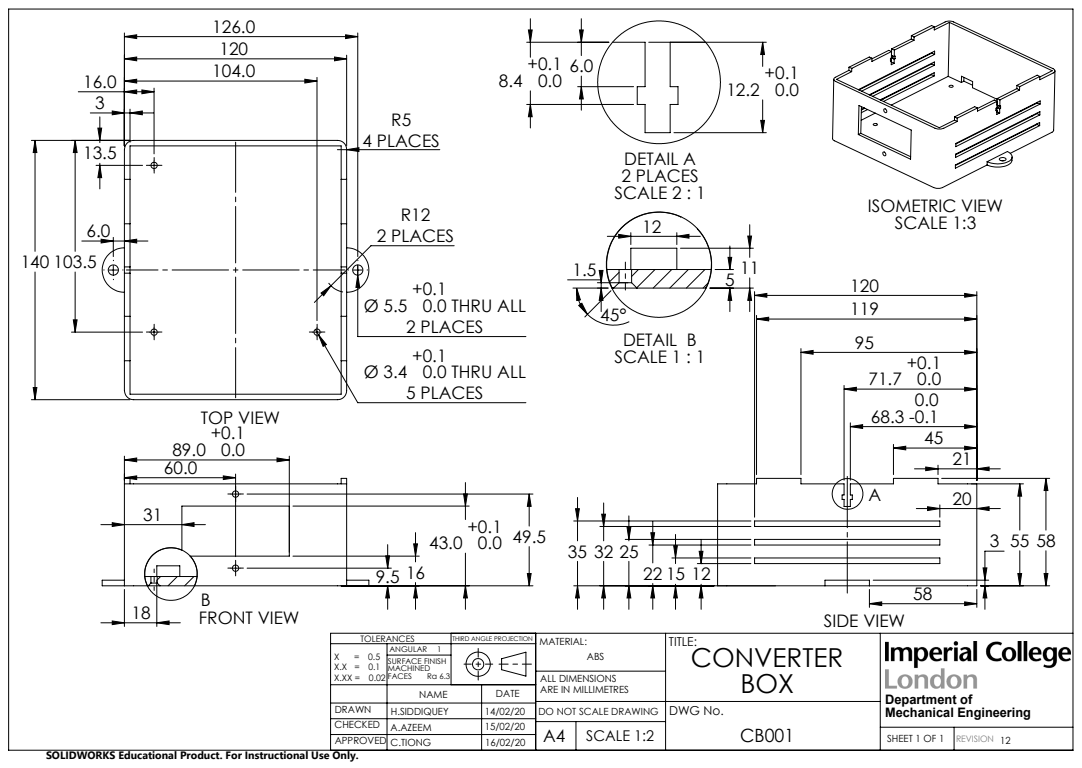
[picture p115: page 1]
0.0 THRU ALL 2 PLACES; 0.0 THRU ALL 5 PLACES; 2 PLACES; 4 PLACES; TOP VIEW; SIDE VIEW; DETAIL A 2 PLACES SCALE 2 : 1; ISOMETRIC VIEW; SCALE 1:3; DETAIL B SCALE 1 : 1; FRONT VIEW; SURFACE FINISH; FACES; ANGULAR 1; DWG No.; A4 SCALE 1:2; SHEET 1 OF 1; REVISION 12; Department of Mechanical Engineering

THIRD ANGLE PROJECTION

ALL DIMENSIONS
ARE IN MILLIMETRES
DO NOT SCALE DRAWING

SOLIDWORKS Educational Product. For Instructional Use Only.
